jorgeab21/Dise-o_De_Prototipos/hardware/README.md

# KIDBOX — PCB v1.0

> ## Versión de fabricación v1.0 (27-oct-2026)
> Los Gerbers de `fabricacion/KIDBOX_gerbers_v1.0.zip` son la versión para pedir a JLCPCB. Aprobada en la revisión 2 del profesor
> (26-oct), con las pistas a 45° y la prueba 1:1 de la 150 × 70 hecha el 27-oct.
>
> **Cerrado antes de fabricar:**
> - [x] **Prueba 1:1 de la 150 × 70 (27-oct):** escala confirmada con regla. Pantalla, DAC (jack centrado, boca al borde), pulsadores, C3,
>       C4, RP2350-Plus, batería y SW10 calzan. C2 no aparece porque se perdió la pieza (es igual a C3): hay uno de repuesto en
>       `BOM_compra.csv`. Fotos en "Prueba 1:1".
> - [x] **Pistas a 45°:** las 33 esquinas a 90° pasaron a chaflanes; `verificar_extra.py` cuenta 0 esquinas a 90°.
> - [x] **Medidas del DAC (23–26 oct):** placa 31.85 × 17.5 mm (17.3–17.5), columna a 1.5 mm del borde corto y centrada, eje del jack a
>       24.9 mm de la columna, jack de 4.7 × 14 mm que sobresale 1.4 mm. Ya están en la huella propia de J5.
> - [x] **DAC con 3V3 (23-oct):** VIN = 3.26 V, A3V3 = 3.27 V, suena en estéreo con audífonos. Puentes: venían abiertos; en este módulo
>       **H3L controla FMT y H4L controla XSMT**. Quedaron FLT/DEMP/FMT = L y **XSMT = H** (3.21 V). VIN se queda en 3V3.
> - [x] **RP2350-Plus:** 21.0 × 51.55 mm y filas a 17.78 mm (confirmado).
> - [x] **Continuidad de SW10 (21-oct):** la palanca une el común con la pata de su lado. OFF = pad conectado a GND.
> - [x] **Condensadores medidos (21-oct):** C2/C3 con paso de 5 mm; C4 de Ø ≈ 4 mm, alto 7–8 mm y paso 1.5 mm (huella P1.50).
>
> **Pendientes de después de la placa** (no la cambian):
> - [ ] **Al soldar J2, revisar con lupa los cruces entre pines:** **LRCK–RUN** (entre J2.29 y J2.30) y **3V3–RUN** (entre J2.30 y J2.31).
>       Un puente ahí reinicia el módulo. Ver "Notas de montaje".
> - [ ] **SW10:** medir en ON y OFF (3V3_EN ≈ VSYS / 0 V) y la corriente de la batería en OFF (esperable del orden de decenas de µA; si
>       pasa de ≈ 1 mA algo queda alimentado). Sugerencia del profesor 3.5.
> - [ ] **TP1–TP2:** ≈ 3.3 V con SW10 en ON; sin continuidad con la placa armada sin módulos.
> - [ ] **Carcasa:** muro colgante entre pantalla y DAC, y bolsillo de la batería (ver "Carcasa").
> - [ ] **Alto real del jack** sobre la placa del DAC (hoy ≈ 6 mm, provisorio): define la abertura de la carcasa, no la placa.
> - [ ] **Polaridad del adaptador de la batería** (lo hace el profesor): medir con el multímetro antes de conectar (rojo = + → ⊕ del BAT).
> - [ ] Pantalla: revisar el puente J1 del módulo (3.3 V). No afecta a la PCB.

## Qué es

Consola portátil educativa basada en el **Game★Mite v1.3.2 de Thomas Hugo Williams (CC BY 4.0)**. Placa de **150 × 70 mm**, 2 capas,
todo THT, **simétrica respecto de x = 75**. Lleva:
- un **Waveshare RP2350-Plus** (J1/J2, por detrás, centrado, con el USB-C en el borde superior);
- una **pantalla TFT ILI9341 de 2.4"** por SPI (J3, por delante), con la **imagen** centrada en la placa (`tft.setRotation(3)`);
- un **DAC PCM5102A (GY-PCM5102)** por I2S (J5, **por delante**, bajo la pantalla), con el **jack de 3.5 mm centrado** en el borde inferior;
- **8 pulsadores** con capuchones redondos de Ø9: cruceta a la izquierda, A y B en espejo a la derecha, SELECT y START abajo;
- un **interruptor ON/OFF** (SW10, por detrás, arriba a la izquierda) que corta 3V3_EN;
- **TP1 (+3V3) y TP2 (GND)**, puntos de prueba junto a C2;
- una **batería LiPo 103450** que va en un bolsillo de la **carcasa**, detrás, no pegada a la PCB (ver "Carcasa"). Está en el esquemático
  como BT1, excluida de la placa.

Volumen por software, con máximo limitado.

**Referencias que faltan:** no hay C1, J4 ni SW9 porque se eliminaron en la v0.7 (RESET del frente y conector de la pantalla). No se
re-anotó para no cambiar referencias que ya están en la documentación y en las fotos.

## Archivos

La carpeta de entrega (`KIDBOX_PCB_v1.0/`, la arma `scripts/gen_entrega.py`) tiene la misma estructura que el repositorio:

| Ruta | Qué es |
| :--- | :--- |
| `README.md` | Este archivo |
| `ESPECIFICACION.md` | Fuente de verdad del proyecto (la escribe el alumno), v1.0 |
| `DECISIONES.md` | Supuestos y decisiones del diseño, fase por fase (la v0.9 está en las secciones 16 y 17; la v1.0, en la 18) |
| `KIDBOX/` | Proyecto KiCad 10: `KIDBOX.kicad_pro`, `.kicad_sch`, `.kicad_pcb`, `.kicad_dru` (reglas de 0.29 mm), `fp-lib-table` y `KIDBOX.pretty/` (huella propia del DAC) |
| `KIDBOX/BOM.csv` | Lista de materiales del esquemático (referencia, valor, huella, cara, notas) |
| `KIDBOX/BOM_compra.csv` | **Lista de compra completa**: módulos, batería, tiras, pulsadores, capuchones, tornillos, sujeción de la batería y la placa, con cantidades, estado y proveedor (o "por cotizar") |
| `KIDBOX/netlist.csv` | Red, componente, pin y función de cada pin |
| `KIDBOX/verificacion/` | ERC/DRC en JSON, estadísticas, esquemático en SVG, cobre frontal y trasero (SVG), vistas 3D (PNG) y fotos de las pruebas 1:1 |
| `scripts/` | Generadores (huella del DAC, esquemático, BOM/netlist, PCB, fabricación, entrega) y verificaciones; cada uno dice cómo se ejecuta en su cabecera |
| `fabricacion/KIDBOX_gerbers_v1.0.zip` | **Lo que se sube a JLCPCB:** Gerbers + taladros Excellon |
| `fabricacion/gerbers/` | Los mismos archivos sueltos, más los mapas de taladros (PDF) y el reporte de taladros |
| `fabricacion/KIDBOX_1a1_frente_A4.pdf`, `KIDBOX_1a1_reverso_A4.pdf` | Frente y reverso (espejado) a escala real en hoja A4, para la prueba de impresión |
| `fabricacion/KIDBOX_1a1_frente_Carta.pdf`, `KIDBOX_1a1_reverso_Carta.pdf` | Lo mismo en hoja Carta |

Para regenerar todo desde cero (con KiCad cerrado), desde la carpeta raíz:

```
python scripts/gen_huella_dac.py
python scripts/gen_esquematico.py
python scripts/gen_bom_netlist.py
"C:\Program Files\KiCad\10.0\bin\python.exe" scripts/gen_pcb.py
python scripts/verificar.py KIDBOX
"C:\Program Files\KiCad\10.0\bin\python.exe" scripts/verificar_extra.py KIDBOX
python scripts/gen_fabricacion.py
python scripts/gen_entrega.py
```

## Prueba 1:1 (27-oct-2026)

Hecha con `fabricacion/KIDBOX_1a1_frente_A4.pdf` y `KIDBOX_1a1_reverso_A4.pdf` impresos al 100 % (la serigrafía de las fotos todavía dice
v0.9: la geometría es la misma de la v1.0, que solo cambió las esquinas de las pistas y el número de versión).

| Foto | Qué muestra |
| :--- | :--- |
| `KIDBOX/verificacion/prueba_1a1_v09_escala_largo.jpg` | Regla sobre el largo: 150 mm |
| `KIDBOX/verificacion/prueba_1a1_v09_escala_alto.jpg` | Regla sobre el alto: 70 mm |
| `KIDBOX/verificacion/prueba_1a1_v09_frente.jpg` | Frente: pantalla, DAC con el jack centrado y la boca en el borde, pulsadores, C3 y C4 (C2 falta: se perdió la pieza) |
| `KIDBOX/verificacion/prueba_1a1_v09_reverso.jpg` | Reverso: RP2350-Plus, batería en su zona de referencia y SW10 |

Las fotos `prueba_1a1_v07_*.jpg` son de la v0.7 y quedan como historial.

## Carcasa: lo que la placa le exige

- **Muro entre la pantalla y el DAC.** En la placa queda una **franja libre de 4.74 mm** en planta, entre el borde inferior del módulo de
  pantalla (y = 46.36) y el contorno del DAC (y = 51.1), a lo ancho del DAC (x 48.6–80.45). En esa franja no hay piezas de la cara Top;
  solo pistas. El muro va **colgado de la tapa frontal**:
  - mide **≈ 2 mm** de ancho y va centrado en y = 48.73 (línea "muro carcasa" en F.Fab);
  - su altura útil va de **9 a 18 mm sobre la PCB**, porque lo que debe tapar es la placa del DAC (≈ 11–18 mm sobre su socket);
  - termina **≥ 4 mm sobre la PCB**. Las soldaduras de J2.21/J2.22 y J1.19/J1.20 (≈ 2 mm de alto) caen dentro de la franja, así que
    **no hay que apoyar el muro sobre ellas**.
- **Batería en la carcasa, no en la PCB.** La LiPo 103450 va en un **bolsillo de la carcasa con fondo de plástico** entre la batería y la
  placa, con una **sujeción propia** (traba o tapa) y un **canal para el cable** hasta el conector BAT del RP2350-Plus. No se pega a la
  PCB. El rectángulo "BATERÍA 103450" de la serigrafía trasera es solo la referencia de dónde queda, con una flecha hacia el conector BAT.
  Ahí no van componentes altos de la cara Bottom, pero sí hay patas THT (las de START), que quedan bajo el fondo del bolsillo.
  **Orientar la batería con el cable hacia el conector BAT** del módulo (como en la foto del reverso), para que el cable sea corto y no
  cruce sobre el módulo.
- **Capuchones redondos Ø9** impresos en 3D: dejan ≥ 1.5 mm de aire a los módulos (el más justo es RIGHT, a 2.41 mm de la pantalla).
- **Aberturas:** USB-C arriba (x 70.7–79.65) y jack abajo (x 72.65–77.35, boca al ras de y = 70, a ≈ 13–19 mm sobre la placa).

## Orden de soldadura

Las piezas de la **cara Bottom** se insertan por detrás y se sueldan por delante. Las de **Top** se insertan por delante y se sueldan
por detrás. Primero va todo Bottom y después Top, de lo más bajo a lo más alto.

| # | Ref | Cara | Pieza | Cuidado |
| :--- | :--- | :--- | :--- | :--- |
| 1 | J1 | Bottom | Tira hembra 1×20 (pines 1–20 del módulo) | Pin 1 = pad cuadrado, junto al USB-C. Cortar al ras |
| 2 | J2 | Bottom | Tira hembra 1×20 (pines 21–40) | **Poco estaño**: por delante pasan entre sus pines el haz SPI, 3V3 y LRCK (ver notas). Cortar al ras |
| 3 | SW10 | Bottom | Interruptor deslizante, paso 2.54 mm | Palanca hacia atrás; pad central = común. Las patas quedan bajo la pantalla: cortar al ras |
| 4 | C2 | Top | 100 nF cerámico (paso 5 mm) | Vertical junto al pin 1 de J3 |
| 5 | C3 | Top | 100 nF cerámico (paso 5 mm) | Vertical entre SELECT y el DAC, encima de C4 |
| 6 | C4 | Top | 10 µF 25 V electrolítico (Ø4 × 7–8 mm, paso 1.5 mm) | **Respetar la polaridad:** + en el pad cuadrado, del lado de J5 (a la derecha visto de frente). La huella ya tiene paso 1.5 mm: no hay que abrir las patas |
| 7 | J3 | Top | Tira hembra 1×14 (pantalla) | Pin 1 (VCC) arriba, marcado "1". Cortar al ras |
| 8 | J5 | Top | Tira hembra 1×6 (DAC) | VIN = pin 1, pad cuadrado, abajo. El DAC va con sus componentes hacia el frente y el jack hacia el borde inferior |
| 9 | SW1–SW8 | Top | Pulsadores 6×6 | Bien apoyados contra la placa para que los capuchones queden a la misma altura |

TP1 y TP2 son pads de la placa: no llevan pieza.

### Notas de montaje
- **J2 con poco estaño.** Entre sus pines pasan, por la cara donde se suelda, todas a 0.295 mm de cada pad:
  - el haz SPI (5 pistas);
  - **3V3**, entre J2.31 (LCD_LED) y J2.30 (RUN);
  - **I2S_LRCK**, entre J2.30 (RUN) y J2.29 (DIN).

  Hay que **revisar con lupa sobre todo los puentes LRCK–RUN y 3V3–RUN**: el primero reiniciaría el módulo cada vez que suena el
  audio, y el segundo dejaría RUN fijo en 3V3 (y LCD_LED en corto con 3V3 si el puente toca J2.31). Medir que no haya continuidad
  entre J2.30 y J2.29, entre J2.30 y J2.31, ni entre 3V3 (TP1) y J2.30 o J2.31.
- **J3 y J5 sin pistas entre sus pines** (v0.9). Se puede soldar normal.
- **DAC adelante:** la tira macho se suelda con el **plástico del lado sin componentes** del módulo. Los componentes del DAC quedan hacia el
  frente y la boca del jack al ras del borde inferior. Bajo el DAC no queda ninguna pata salvo las de J5, así que el módulo también se
  puede soldar directo a la placa para bajar el grosor.
- **Puentes del DAC:** FLT, DEMP y FMT = L; **XSMT = H** (sin él, el DAC queda en silencio). En este módulo H3L controla FMT y H4L controla XSMT.
- **Cortar al ras las patas de J1, J2, J3 y SW10** después de soldar: las de J1/J2 y SW10 quedan bajo la pantalla.
- La placa no tiene vías. La cara de atrás es un plano de masa con alivios térmicos, así que los pads de GND se sueldan igual que los demás.
- Antes de poner los módulos: medir que no haya corto entre **TP1 (3V3) y TP2 (GND)**.
- Firmware: `tft.setRotation(3)`; volumen limitado por software.

## Pedido en JLCPCB

| Parámetro | Valor |
| :--- | :--- |
| Archivo | `fabricacion/KIDBOX_gerbers_v1.0.zip` (extensiones Protel, Gerber X2, taladros Excellon en mm con origen absoluto) |
| Base material | FR-4 |
| Layers | **2** |
| Dimensions | **150 × 70 mm** (lo detecta solo; el sobrecosto por pasar de 100 × 100 mm está aceptado) |
| PCB Qty | 5 (mínimo) |
| Product type | Industrial/Consumer electronics |
| Different design | 1 |
| Delivery format | Single PCB |
| PCB thickness | **1.6 mm** |
| PCB color | **Verde** |
| Silkscreen | Blanco |
| Surface finish | **HASL (with lead free)** |
| Outer copper weight | 1 oz |
| Via covering | Tented (la placa no tiene vías) |
| Mark on PCB / order number | **Order number: Specify a location**: va donde está el texto "JLCJLCJLCJLC" de la serigrafía inferior, dentro de la zona de batería |
| Gold fingers, castellated holes, edge plating | No |
| **PCB Assembly (PCBA)** | **No** (sin ensamblaje) |
| Stencil | No |
| Resto de opciones | Las que JLCPCB trae por defecto |

## Qué revisar en el visor de Gerbers de JLCPCB antes de pagar

1. **2 capas y 150 × 70 mm.** El contorno tiene esquinas redondeadas (r = 4 mm), sin líneas sueltas ni recortes de más.
2. **Taladros: 107 en total.**
   - 103 metalizados: 2 × 0.6 mm (C4), 7 × 0.8 mm (C2, C3 y SW10), 62 × 1.0 mm (J1, J2, J3, J5, TP1 y TP2) y 32 × 1.1 mm (pulsadores).
   - 4 sin metalizar de 2.2 mm, en las esquinas (4, 4), (146, 4), (4, 66) y (146, 66).
   - Dentro del rectángulo "BATERÍA 103450" (por detrás) solo caen las patas de START: la batería va en la carcasa, no sobre la placa.
3. **Cobre superior (Top):** todas las pistas están aquí, con todas las esquinas a 45° (ninguna a 90°). Las de señal son de 0.25 mm y las de 3V3 de 0.5 mm, salvo un tramo de 0.25 mm entre
   dos pines de J2. Ninguna pista toca un pad que no le corresponde. No hay vías.
4. **Cobre inferior (Bottom):** un plano de masa casi completo. Los pads de GND tienen alivios térmicos (4 "radios") y los demás pads,
   un anillo libre a su alrededor. No hay pistas.
5. **Máscara:** hay abertura en todos los pads, y ninguna sobre las pistas ni sobre el plano.
6. **Serigrafía superior:**
   - UP, DOWN, LEFT, RIGHT, A, B, SELECT y START junto a sus botones (texto de 1.2 mm);
   - el contorno de la pantalla con "PANTALLA TFT 2.4" (J3)" y "1" junto al pin 1 de J3, y dentro el contorno de la imagen;
   - el contorno del DAC con el jack, "DAC PCM5102", "VIN" y "GND" junto a J5;
   - "3V3" y "GND" junto a TP1 y TP2;
   - los créditos del Game*Mite entre el DAC y START.
7. **Serigrafía inferior.** En la vista desde arriba se ve espejada, que es lo correcto; al dar vuelta la placa en el visor se lee al derecho:
   - "VISTA POSTERIOR / FILAS ESPEJADAS", el contorno de la RP2350-Plus con el USB-C arriba y "1" en J1 y J2;
   - "OFF" y "ON" en SW10 (desde atrás, arriba a la derecha, con OFF a la izquierda);
   - "BATERÍA 103450 / va en la carcasa, no pegar a la PCB" con una flecha hacia el conector BAT, y el cajetín
     "KIDBOX v1.0 – 150 x 70 mm – 1.6 mm – 2 capas" abajo (a la izquierda al dar vuelta la placa).
8. Ningún texto de serigrafía cae sobre un pad. El DRC dio 0 avisos, pero hay que confirmarlo a la vista.
9. En la serigrafía inferior aparece **"JLCJLCJLCJLC"** en vertical, dentro de la zona de batería, junto a "BATERÍA 103450". Ahí JLCPCB pone su número de pedido (con "Specify a location").
10. Precio y plazo coherentes con 5 placas de 150 × 70 mm, sin ensamblaje ni opciones extra marcadas por error.

## Verificación del diseño (27-oct-2026)

`verificar.py`: ERC 0/0 · DRC 0 errores, 0 avisos (con las reglas de 0.29 mm de `KIDBOX.kicad_dru`) · 0 sin conectar · paridad
esquemático-PCB 0 · mínimos DFM OK.

`verificar_extra.py`:
- ERC y DRC con los tests que el proyecto ignora activados: 0.
- Emulación de "Actualizar PCB desde esquemático" (F8): 0 cambios.
- Esquinas de pista: 115 vértices, 112 a 45° y 3 colineales; **0 a 90°**.

Detalle y holguras medidas en `DECISIONES.md`, secciones 16 a 18.

Licencia y créditos: basado en el Game★Mite de Thomas Hugo Williams (CC BY 4.0).
