jorgeab21/Dise-o_De_Prototipos/hardware/fabricacion/gerbers/KIDBOX-drill_report.txt

Drill report for KIDBOX.kicad_pcb
Created on 2026-10-27T09:46:37

Copper Layer Stackup:
    =============================================================
    L1 :  F.Cu                      front
    L2 :  B.Cu                      back

Drill file 'KIDBOX-PTH.drl' contains
    plated through holes:
    =============================================================
    T1  0.600mm  0.0236"  (2 holes))
    T2  0.800mm  0.0315"  (7 holes))
    T3  1.000mm  0.0394"  (62 holes))
    T4  1.100mm  0.0433"  (32 holes))

    Total plated holes count 103

Drill file 'KIDBOX-NPTH.drl' contains
    unplated through holes:
    =============================================================
    T1  2.200mm  0.0866"  (4 holes))

    Total unplated holes count 4
