jorgeab21/Dise-o_De_Prototipos/4.KIDBOX_Diagrama_arquitectura_del_Sistema.md

# KIDBOX — Diagrama y Arquitectura del Sistema
**Documento de Arquitectura de Hardware, Software e Integración Tecnológica · Versión 1.0 (KIDBOX V1)**  
*Proyecto: Consola Portátil Educativa para Niños de 6 a 10 Años*

---

## 1. Arquitectura de Hardware

La arquitectura de hardware de **KIDBOX V1** se articula en torno al microcontrolador **RP2350A** montado en la placa de desarrollo **Waveshare RP2350-Plus**. Este microcontrolador gobierna directamente los periféricos de salida visual (SPI), audio digital (I2S) y entrada de usuario (GPIO dedicados).

### 1.1. Diagrama de Conexiones y Buses

```text
                                 KIDBOX V1
                                     │
                           Waveshare RP2350-Plus
                                 (RP2350A)
                                     │
          ┌──────────────────────────┼──────────────────────────┐
          │                          │                          │
       Bus SPI                    Bus I2S                   GPIO Directo
          │                          │                          │
          ▼                          ▼                          ▼
    ILI9341 2.4"                 PCM5102A                   8 botones
      320 × 240                      │                    ↑ ↓ ← →, A, B
          │                          ▼                    Start, Select
          │                          │                   (+ RESET → RUN)
          │                     Jack 3.5 mm
          │                          │
          │                          ▼
          │                      Audífonos
          │
    ┌─────┴──────┐
    │  XPT2046   │  ───► [NO USADO en V1: sin cablear en la PCB]
    │ Touch SPI  │
    ├────────────┤
    │  MicroSD   │  ───► [NO USADO en V1: sin cablear en la PCB]
    │ Socket SPI │
    └────────────┘
```

El detalle de cada conexión (esquemático aprobado, ERC sin errores) está en [hardware/KIDBOX/KIDBOX.kicad_sch](hardware/KIDBOX/KIDBOX.kicad_sch) y [hardware/KIDBOX/netlist.csv](hardware/KIDBOX/netlist.csv).

---

### 1.2. Sistema de Energía y Alimentación

La placa Waveshare RP2350-Plus integra la etapa de gestión de potencia, evitando la necesidad de módulos de carga externos adicionales como el TP4056:

```text
                           SISTEMA DE ENERGÍA

                         Batería LiPo 3.7 V (1S)
                              1000–1200 mAh
                                    │
                                    ▼ [Conector 2P, paso 1,25 mm]
                          Waveshare RP2350-Plus
                     ┌──────────────┴──────────────┐
                     │                             │
             Cargador Integrado            Regulación Integrada
                 (ETA6096)                       (MP28164)
                     │                             │
              Puerto USB-C                  Alimentación 3.3 V
         (Carga y Programación)                    │
                                            Pin 3V3_EN (red PWR_EN)
                                                   │
                                             Interruptor ON/OFF
                                     (deslizante recto, cara posterior, a GND)
```

> [!TIP]
> **Gestión de Encendido Limpia:**  
> El interruptor de encendido general conmuta el pin `3V3_EN` a `GND`. Esto apaga el convertidor DC-DC interno MP28164 (buck-boost que genera los 3,3 V de la electrónica) sin cortar la línea directa entre la batería y el cargador ETA6096, permitiendo recargar la consola mediante USB-C incluso estando apagada.

> [!WARNING]
> **Corriente de carga:** el ETA6096 viene configurado a ~1 A. Con la batería actual de 500 mAh eso es ~2C, el doble de lo recomendable. Se decide con el profesor el 14-oct (batería de 1000–1200 mAh o cambio de R13). Mientras tanto, las pruebas se hacen solo por USB-C, sin batería conectada.

---

## 2. Presupuesto General de Pines GPIO

Gracias a la alta disponibilidad de pines del microcontrolador RP2350A en la placa Waveshare, **no se requiere el uso de expansores I²C (e.g. PCF8574), matrices de teclado ni registros de desplazamiento (e.g. 74HC165)**. Todos los componentes se conectan a líneas dedicadas:

| Bloque Funcional | Líneas / Pines Asignados | Detalle de Señales |
|:---|:---:|:---|
| **Botones Físicos (8 de juego)** | **8** | `DOWN` GP16, `LEFT` GP17, `UP` GP18, `RIGHT` GP19, `SELECT` GP12, `START` GP13, `B` GP14, `A` GP15. Cada botón conecta su GPIO a GND; pull-up interno activado por software (pulsado = LOW). |
| **Pantalla TFT ILI9341 (SPI0)** | **6** | `CS` GP0, `RST` GP1, `DC` GP2, `MOSI` GP3, `SCK` GP6 y `LED` GP26 (brillo por PWM). MISO no se usa. |
| **DAC de Audio PCM5102A (I2S)** | **3** | `BCK` GP20, `LRCK` GP21 (deben ser consecutivos para la librería I2S) y `DIN` GP22. El pin `SCK` del DAC va a GND (reloj interno). |
| **Control del módulo** | **2 (no son GPIO)** | `RESET` al pin `RUN`; interruptor ON/OFF al pin `3V3_EN`. |
| **Telemetría de Batería** | **Por verificar** | En la Raspberry Pi Pico, VSYS/3 se lee en un canal ADC interno; falta confirmar en el esquemático de la RP2350-Plus si existe el mismo divisor. |
| **TOTAL EN USO** | **17 GPIO** | Quedan libres GP4, GP5, GP7–GP11, GP27 y GP28. |

> [!NOTE]
> Los pines correspondientes al digitalizador táctil (XPT2046) y al lector de tarjeta MicroSD de la pantalla **no se cablean en la PCB** de KIDBOX V1, simplificando el ruteo y reduciendo el consumo energético.

---

## 3. Arquitectura del Software

El flujo lógico del sistema está diseñado para ofrecer una experiencia cerrada, amigable y centrada en el bienestar infantil, garantizando sesiones de juego con límites temporales automáticos.

### 3.1. Flujo de Ejecución y Ciclo de Vida

```text
                     ENCENDIDO
                         │
                         ▼
             Inicialización Hardware
        (Reloj, Display SPI, DAC I2S, GPIOs)
                         │
                         ▼
                    Logo KIDBOX
                (Jingle de bienvenida)
                         │
                         ▼
                  MENÚ PRINCIPAL
                         │
          ┌──────────────┴──────────────┐
          │                             │
     Categoría:                    Categoría:
      [ JUGAR ]                   [ APRENDER ]
          │                             │
          └──────────────┬──────────────┘
                         │
                         ▼
                  Selección Juego
                         │
                         ▼
               Inicio Temporizador
             (Sesión limitada activa)
                         │
                         ▼
                     GAMEPLAY
                         │
                         ▼
             Aviso de Tiempo Restante
             (Alerta visual / acústica)
                         │
                         ▼
                  FIN DE SESIÓN
         (Pausa amigable de tiempo cumplido)
                         │
                         ▼
                  Menú Principal
```

### 3.2. Catálogo Inicial de Software

Los títulos de lanzamiento para KIDBOX V1 se agrupan en dos categorías balanceadas:

```
                    BIBLIOTECA DE TÍTULOS (V1)
 ┌──────────────────────────────────────────────────────────────────┐
 │                     JUEGOS EDUCATIVOS                            │
 │  • Memoria: Secuencias de colores y sonidos (tipo Simon Says)     │
 │  • Matemáticas: Desafíos rápidos de cálculo mental y sumas        │
 │  • Lógica y Patrones: Completar secuencias lógicas y matrices     │
 │  • Reacción: Estimulación visomotora con pulsación oportuna       │
 ├──────────────────────────────────────────────────────────────────┤
 │                  JUEGOS DE ENTRETENIMIENTO                       │
 │  • Snake: Navegación clásica y control de velocidad en cuadrícula │
 │  • Pong: Juego de raquetas con rebote angular                     │
 │  • Breakout / Ladrillos: Destrucción de bloques con física básica│
 └──────────────────────────────────────────────────────────────────┘
```

> [!IMPORTANT]
> **Pendiente de decisión del equipo:** la propuesta original ([Documentacion/KIDBOX.md](Documentacion/KIDBOX.md)) define una biblioteca de **3 a 4 juegos**, cada uno con un objetivo cognitivo, con un diseño que acompaña la frustración (**sin cronómetro ni pantalla de game over**) y sin mecánicas de presión. Varios títulos de este catálogo (Snake, Pong, Breakout, desafíos "rápidos" y de reacción) incluyen game over o presión de tiempo. Hay que definir si se mantienen (por ejemplo, adaptados con dificultad adaptativa y sin game over), se reemplazan o se reduce el catálogo.

### 3.3. Plataforma de Desarrollo

- **Entorno:** Arduino IDE (recomendación del profesor), con el núcleo *arduino-pico*, que soporta RP2040 y RP2350.
- **Librerías:** pantalla ILI9341 por SPI y salida de audio I2S. Las librerías específicas quedan por definir en las pruebas de protoboard.
- **Carga del firmware:** por USB-C, arrastrando el archivo UF2 o directamente desde el IDE.
- **Rotación de pantalla:** el módulo va montado girado 180° en la PCB; la imagen se endereza por software (`setRotation`).

---

## 4. Estrategia Tecnológica: Open Source vs. Desarrollo Propio

El proyecto adopta un enfoque híbrido pragmático: aprovecha referencias técnicas y librerías probadas de código abierto para acelerar la validación funcional, pero desarrolla de forma propietaria la electrónica, el diseño industrial y la experiencia de usuario:

| Componente / Módulo | Tipo de Origen | Descripción y Rol en el Proyecto |
|:---|:---:|:---|
| **Game★Mite** (CC BY 4.0) | `Referencia Open Source` | Base del hardware: asignación de pines de pantalla y botones, módulos sobre tiras hembra y criterio de batería. Se le da crédito en la serigrafía de la PCB. |
| **PicoMite (MMBasic)** | `Referencia` | Firmware que usa el Game★Mite. KIDBOX **no** lo usa: el firmware se programa en Arduino. |
| **ESP32-Emu-Turbo** | `Referencia Mecánica` | Estudio previo de integración volumétrica de componentes y ergonomía de carcasas impresas. |
| **Carrier PCB KIDBOX** | `Desarrollo Propio` | Placa portadora de 2 capas diseñada desde cero para interconectar módulos, pulsadores y regulación. |
| **Carcasa KIDBOX** | `Desarrollo Propio / Adaptado` | Diseño CAD 3D exclusivo con bisel protector de pantalla, bahía aislada para LiPo y ensamblado con insertos M2. |
| **Distribución Ergonómica** | `Desarrollo Propio` | Geometría horizontal calibrada con separación de controles adecuada para manos infantiles (6 a 10 años). |
| **Interfaz Gráfica KIDBOX** | `Desarrollo Propio` | Sistema de menús minimalistas, iconografía de alta legibilidad y navegación amigable sin distracciones. |
| **Temporizador de Sesión** | `Desarrollo Propio` | Rutina en background que gestiona el control de tiempo saludable y lanza avisos sonoros/visuales de término de sesión. |
| **Juegos Educativos** | `Desarrollo Propio / Adaptado` | Mecánicas diseñadas específicamente para ejercitar atención, cálculo mental, memoria y tolerancia a la frustración. |

---

## 5. Documentos Relacionados

- **Requisitos del Producto:** [1.KIDBOX_Requisitos_y_Requerimientos_Tecnicos.md](1.KIDBOX_Requisitos_y_Requerimientos_Tecnicos.md)
- **Diseño Mecánico y Bocetos:** [2.KIDBOX_Diagramas_Bocetos_Diseno_Fisico.md](2.KIDBOX_Diagramas_Bocetos_Diseno_Fisico.md)
- **Lista de Materiales (BOM):** [3.KIDBOX_Lista_componentes_electrónicos.md](3.KIDBOX_Lista_componentes_electrónicos.md)
- **Especificación y esquemático de la PCB:** [hardware/ESPECIFICACION.md](hardware/ESPECIFICACION.md) · [hardware/KIDBOX/](hardware/KIDBOX/)
