jorgeab21/Dise-o_De_Prototipos/1.KIDBOX_Requisitos_y_Requerimientos_Tecnicos.md

# KIDBOX — Lista de Requisitos y Requerimientos Técnicos
**Documento de Especificación de Producto · Versión 1.0 (KIDBOX V1)**  
*Proyecto: Consola Portátil Educativa para Niños de 6 a 10 Años*

---

## 1. Objetivo del Producto

> **KIDBOX** es una consola portátil orientada a niños de 6 a 10 años, diseñada para ofrecer juegos educativos y de entretenimiento en un entorno controlado, sin navegador, publicidad, compras integradas, redes sociales ni otras distracciones propias de un teléfono inteligente o tablet.

El propósito central es proporcionar a los cuidadores una alternativa confiable y saludable frente a las pantallas convencionales, permitiendo a los niños entrenar habilidades cognitivas (atención, memoria, razonamiento lógico y tolerancia a la frustración) mediante dinámicas de juego atractivas y sesiones de tiempo autolimitadas por el propio hardware.

---

## 2. Requisitos Funcionales

La priorización sigue el estándar **MoSCoW** adaptado al prototipo de ingeniería (*Debe tener* / *Deseable*):

| ID | Requisito Funcional | Prioridad | Descripción / Criterio de Aceptación |
|:---:|:---|:---:|:---|
| **RF01** | **Operación 100% Offline** | `Debe tener` | El dispositivo funciona de manera autónoma sin requerir conectividad Wi-Fi, Bluetooth o acceso a Internet durante su operación normal. |
| **RF02** | **Ejecución de Juegos Educativos y Lúdicos** | `Debe tener` | Capacidad de inicializar y alternar entre títulos de juego prediseñados para la plataforma. |
| **RF03** | **Enfoque en Desarrollo Cognitivo** | `Debe tener` | La biblioteca incluye dinámicas orientadas a la ejercitación de memoria, lógica deductiva, cálculo mental, reconocimiento de patrones y tiempo de reacción. |
| **RF04** | **Navegación por Controles Físicos** | `Debe tener` | Interacción completa de menús y gameplay efectuada exclusivamente mediante la cruceta direccional y pulsadores físicos dedicados. |
| **RF05** | **Temporizador de Sesión Incorporado** | `Debe tener` | Control interno de tiempo de uso continuo que establece límites saludables de juego predefinidos. |
| **RF06** | **Notificación de Término de Sesión** | `Debe tener` | La consola alerta de forma visual y sonora al usuario cuando el tiempo límite de juego concluye, bloqueando o pausando amigablemente la partida. |
| **RF07** | **Entorno Seguro sin Distracciones** | `Debe tener` | Ausencia total de navegadores web, pasarelas de pago, micropagos, anuncios publicitarios o acceso a plataformas de interacción social. |
| **RF08** | **Interfaz Gráfica Intuitiva** | `Debe tener` | Menú principal y señalética visual sencilla, comprensible, accesible e iconográfica para el público infantil de 6 a 10 años. |
| **RF09** | **Ejecución Autónoma desde Memoria Interna** | `Debe tener` | Los juegos y assets se leen y ejecutan directamente desde la memoria Flash del microcontrolador, sin dependencia obligatoria de medios extraíbles. |
| **RF10** | **Escalabilidad para Touch y MicroSD** | `Deseable` | El hardware deja disponibles los pines y pistas para habilitar en revisiones futuras (V2+) el panel táctil resistivo y/o el lector de tarjetas MicroSD. |

---

## 3. Requerimientos Técnicos

Especificación técnica de la plataforma de hardware para la versión de validación **KIDBOX V1**:

| Subsistema / Parámetro | Requerimiento KIDBOX V1 | Especificación Técnica & Justificación |
|:---|:---|:---|
| **Microcontrolador (MCU)** | Waveshare RP2350-Plus | Arquitectura dual-core ARM Cortex-M33 / Hazard3 RISC-V @150 MHz, alto rendimiento gráfico y periféricos PIO. |
| **Pantalla Display** | TFT IPS 2.4" ILI9341 | Panel color de 262K colores, ángulo de visión amplio, controlador ILI9341 integrado. |
| **Resolución** | 240 × 320 px (orientación 320 × 240) | Uso prioritario en orientación apaisada (*landscape*) para adaptarse al formato ergonómico de consola portátil. |
| **Bus de Comunicación Display** | SPI dedicado | Interfaz de 4 hilos a alta frecuencia para refresco de cuadros óptimo. |
| **Interfaz de Control** | 8 botones físicos tipo Tact Switch | D-Pad (↑, ↓, ←, →), botones de acción (A, B) y utilitarios (Start, Select) mediante switches de 6×6 mm con lectura por GPIO directo con pull-up. |
| **Procesamiento de Audio** | DAC I2S PCM5102A (GY-PCM5102) | Decodificación de audio digital por I2S de alta fidelidad, con bajo consumo y bajo nivel de ruido. |
| **Salida de Audio** | Jack de audio estéreo 3.5 mm | Conector hembra integrado en el módulo DAC para audífonos estándar (limita el ruido ambiental para terceros). |
| **Almacenamiento Primario** | Memoria Flash integrada en placa MCU | Flash QSPI (≥4 MB / 16 MB) para almacenamiento directo de binarios de firmware, sprites y pistas de audio sintetizadas. |
| **Zócalo MicroSD** | Físicamente presente, no habilitado en V1 | Conector de la pantalla reservado sin cablear en firmware inicial para simplificar validación en protoboard/carrier. |
| **Digitalizador Táctil (Touch)** | Controlador XPT2046 presente, no utilizado | Deshabilitado en V1 para centrar toda la experiencia en controles mecánicos robustos. |
| **Batería** | LiPo 1S 3.7 V (1000–1200 mAh) | Celda recargable de polímero de litio con circuito de protección PCM incorporado (tolerancia dimensional estricta ≤10 mm de espesor). |
| **Circuito de Carga** | ETA6096 integrado en RP2350-Plus | Carga lineal administrada directamente en el módulo MCU mediante conector JST 1.25 mm a ~1 A. |
| **Corriente Admisible de Celda** | $\ge 1\text{ A}$ continuo | Certificada por ficha técnica para garantizar una recarga segura al régimen nominal del cargador integrado. |
| **Autonomía Estimada** | 4 a 6 horas continuas | Estimación sujeta a perfil de brillo de backlight y volumen sonoro medio; pendiente de validación empírica. |
| **Control de Encendido** | Switch mecánico a pin `PWR_EN` | Conmutador ON/OFF conectado entre `PWR_EN` y `GND` que desactiva el regulador MP28164 sin cortar la línea de recarga USB-C. |
| **Placa de Enlace (Carrier PCB)** | PCB personalizada de 2 capas | Placa portadora para ruteo de señales, distribución de masas continuas y desacoplo capacitivo. |
| **Puerto de Alimentación / Debug**| USB Tipo-C | Conector reversible en módulo Waveshare para programación mediante UF2 y suministro de carga. |
| **Montaje y Conectividad** | Headers 2.54 mm & componentes THT | Ensamblado modular desmontable mediante tiras de pines para facilitar diagnóstico, reemplazo y medición en laboratorio. |

> [!NOTE]
> Para conocer el desglose detallado de piezas, estados de disponibilidad en el DEC UAI y proveedores, consultar el archivo [3.KIDBOX_Lista_componentes_electrónicos.md](file:///c:/Users/Usuario/Dise-o_De_Prototipos/3.KIDBOX_Lista_componentes_electrónicos.md).

---

## 4. Requisitos Físicos, Ergonómicos y de Uso

### 4.1. Filosofía de Diseño Infantil
La consola está concebida bajo criterios estrictos de seguridad y adaptabilidad biomecánica para usuarios de 6 a 10 años:
- **Agarre ergonómico:** Bordes perimetrales suavizados y esquinas redondeadas con radio amplio, evitando cantos vivos o aristas punzantes.
- **Distribución de mandos:** Botones de dimensiones adecuadas, con espaciado generoso para evitar pulsaciones involuntarias en manos en etapa de desarrollo motor.
- **Protección de pantalla:** El panel TFT debe estar ubicado en un plano rebajado (*recessed*) dentro del bisel de la carcasa, protegiéndolo de impactos directos al apoyar o caer boca abajo.
- **Seguridad pasiva:** Compartimento de batería inaccesible para el niño, sin piezas desmontables pequeñas que presenten riesgo de atragantamiento o ingestión.

### 4.2. Metas Paramétricas y Mecánicas

| Parámetro Físico | Valor Objetivo V1 | Criterio de Diseño & Verificación |
|:---|:---:|:---|
| **Ancho total** | ~150 – 170 mm | Permite una separación cómoda de ambas manos en agarre horizontal. |
| **Alto total** | ~70 – 90 mm | Altura reducida para que los pulgares alcancen naturalmente el D-Pad y botones. |
| **Grosor máximo** | $\le 35\text{ mm}$ | Balance entre robustez estructural y volumen manejable para niños. |
| **Peso total** | $\le 250\text{ g}$ | Evita fatiga muscular durante sesiones de 20–40 minutos. |
| **Disposición de Pantalla** | Frontal centrada | Minimiza inclinación del cuello y maximiza balance simétrico del peso. |
| **Alojamiento de Batería** | Bahía aislada sin compresión | Espacio de $\sim 21.5 \times 54\text{ mm}$ con tolerancia libre para prevenir estrés mecánico en la celda LiPo. |
| **Método de Ensamble** | Tornillos M2/M2.5 con insertos roscados | Uniones roscadas fiables y duraderas que permiten desarmar y calibrar sin desgastar el plástico impreso. |
| **Resistencia Mecánica** | Grado doméstico infantil | Estructura exterior capaz de soportar torsiones leves, caídas accidentales de baja altura (~1 m sobre madera) y uso rudo diario. |

---

## 5. Resumen de Estados de Implementación

```
                    ARQUITECTURA DE REQUISITOS (V1)
 ┌───────────────────────────────────────────────────────────────────┐
 │                       REQUISITOS BASE (100% CUMPLIDOS)            │
 │  • Funcionamiento Offline autónomo                                │
 │  • Interfaz gráfica infantil y amigable                           │
 │  • Juegos cognitivos y lúdicos en memoria interna                 │
 │  • Control físico integral (8 botones)                            │
 │  • Gestión de sesión (tiempo y alerta)                            │
 ├───────────────────────────────────────────────────────────────────┤
 │                    PLATAFORMA HARDWARE ACTIVA                     │
 │  • MCU Waveshare RP2350-Plus + TFT 2.4" SPI                       │
 │  • DAC I2S PCM5102A + Jack 3.5mm                                  │
 │  • LiPo 1S + Cargador ETA6096 + Switch a PWR_EN                   │
 ├───────────────────────────────────────────────────────────────────┤
 │                   RESERVADO PARA FASES POSTERIORES                │
 │  • Digitalizador Touch XPT2046                                    │
 │  • Slot lector MicroSD externo                                    │
 └───────────────────────────────────────────────────────────────────┘
```
