jorgeab21/Dise-o_De_Prototipos/6.KIDBOX_Plan_de_Desarrollo.md

# KIDBOX — Plan de Desarrollo y Gestión de Riesgos
**Cronograma Maestro, Plan de Contingencias y Priorización de Desarrollo · Entrega Final: 13 de Noviembre de 2026**  
*Proyecto: Consola Portátil Educativa para Niños de 6 a 10 Años (KIDBOX V1)*

---

## 1. Estrategia General de Desarrollo

Tomando como fecha límite improrrogable el **13 de noviembre de 2026**, la estrategia de ingeniería se fundamenta en:

1. **Cierre temprano de arquitectura de hardware:** Congelar componentes críticos de inmediato para disparar los pedidos de compra y el diseño de la PCB sin retrasos de logística.
2. **Desarrollo concurrente en banco de pruebas:** Trabajar el firmware sobre protoboard en paralelo a los tiempos de fabricación y envío de la placa de circuito impreso.
3. **Margen holgado de integración:** Reservar los últimos 10 días exclusivamente para ensamble físico, calibración de autonomía de batería, pruebas de estrés con usuarios y documentación final.

---

## 2. Cronograma Maestro de Hitos

El plan se divide en cinco etapas coordinadas:

| Fecha Estimada | Fase / Hito Principal | Resultado Entregable Esperado | Estado / Responsabilidad |
|:---:|:---|:---|:---:|
| **13 – 15 oct** | **Congelar arquitectura y BOM** | Lista de materiales cerrada: Waveshare RP2350-Plus, TFT ILI9341 2.4", DAC PCM5102A y batería LiPo 1S definidos. | `Hito Crítico` |
| **14 – 18 oct** | **Prototipo electrónico inicial** | Validación en protoboard: pantalla SPI, pulsadores GPIO y audio I2S verificados individualmente. | `En Proceso` |
| **15 – 19 oct** | **Esquemático KiCad** | Circuito completo interconectado, asignación de pines GPIO definitiva y verificación ERC sin errores. | `Planificado` |
| **19 – 23 oct** | **Layout PCB (2 capas)** | Ruteo de señales de alta velocidad (SPI), planos de masa analógica/digital y distribución física de pulsadores. | `Planificado` |
| **23 – 24 oct** | **Revisión DRC y fabricación** | Verificación de reglas de diseño (DRC) del fabricante y generación de archivos Gerber / Drill. | `Planificado` |
| **24 – 25 oct** | **Envío a fabricación PCB** | Orden de fabricación emitida a fábrica (e.g. JLCPCB / PCBWay) para asegurar entrega en plazo. | `Hito Crítico` |
| **18 – 30 oct** | **Firmware base y subsistemas** | Drivers de pantalla, lectura de pulsadores con debouncing por interrupción y máquina de estados del menú principal. | `Concurrente` |
| **22 oct – 3 nov** | **Desarrollo de biblioteca de juegos** | Implementación del primer conjunto jugable (juegos educativos de cálculo/memoria y clásicos lúdicos). | `Concurrente` |
| **22 oct – 3 nov** | **Diseño CAD de carcasa 3D** | Modelado 3D en CAD con bisel rebajado para TFT, alojamiento de celda LiPo e insertos roscados M2/M2.5. | `Concurrente` |
| **3 – 7 nov** | **Recepción y montaje de PCB** | Soldadura de conectores hembra, headers 2.54 mm, tact switches y pasivos en la carrier PCB. | `Planificado` |
| **6 – 9 nov** | **Integración mecatrónica completa** | Ensamble de PCB + pantalla + DAC + batería dentro de la carcasa impresa 3D mediante tornillería métrica. | `Hito Crítico` |
| **9 – 11 nov** | **Pruebas de validación y estrés** | Medición de autonomía real (h), respuesta táctil de botones, calidad de audio y ciclo del temporizador. | `Planificado` |
| **11 – 12 nov** | **Ajustes finales y memoria técnica** | Correcciones menores de software, pulido estético de carcasa y redacción del informe técnico final. | `Planificado` |
| **13 nov** | **ENTREGA FINAL DEL PRODUCTO** | **Presentación y entrega formal de la consola KIDBOX V1 operativa.** | `ENTREGA` |

---

## 3. Prioridad de Desarrollo Incremental (Estrategia MVP)

Para evitar llegar a la fecha límite con múltiples módulos a medio terminar, se adopta un **enfoque incremental estricto**. No se avanza al siguiente paso sin tener el anterior 100% operativo y probado:

```text
 ┌─────────┐      ┌─────────┐      ┌─────────┐      ┌──────────┐      ┌─────────┐
 │ 1. TFT  │ ───► │ 2. Gpio │ ───► │ 3. Menú │ ───► │ 4. Juego │ ───► │ 5. Audio│
 │ Display │      │ Botones │      │ Sistema │      │ Piloto 1 │      │   I2S   │
 └─────────┘      └─────────┘      └─────────┘      └──────────┘      └─────────┘
                                                                           │
 ┌───────────────┐      ┌───────────────┐      ┌───────────────┐           │
 │ 9. Integración│ ◄─── │  8. Carcasa   │ ◄─── │ 7. Catálogo   │ ◄─────────┘
 │     Final     │      │   Impresa 3D  │      │ Resto Juegos  │  [+ 6. Batería LiPo]
 └───────────────┘      └───────────────┘      └───────────────┘
```

### Justificación de la Secuencia:
1. **Pantalla:** La retroalimentación visual es indispensable para diagnosticar y depurar todo el resto del sistema.
2. **Botones:** Permite interactuar con la consola de forma física sin depender del puerto serie del PC.
3. **Menú Base:** Establece la máquina de estados sobre la cual correrán todos los títulos.
4. **Primer Juego Piloto:** Demuestra la viabilidad del ciclo de refresco (*game loop*) y tiempo de respuesta.
5. **Audio I2S:** Aporta enriquecimiento sonoro sin condicionar el avance de la lógica de juego.
6. **Batería:** Asegura la portabilidad una vez estabilizado el consumo promedio.
7. **Resto de Juegos:** Expansión modular del catálogo educativo/lúdico.
8. **Carcasa e Integración:** Solo se imprime y ajusta con las medidas reales y validadas de los módulos ensamblados.

---

## 4. Matriz de Riesgos y Planes de Contingencia (Plan B)

Cada contingencia técnica y logística cuenta con un procedimiento de mitigación predefinido para proteger la entrega final:

| Riesgo Técnico / Logístico | Nivel de Impacto | Plan de Contingencia Inmediato (Plan B) |
|:---|:---:|:---|
| **Retraso en la llegada de la PCB** | `Alto` | Montaje del circuito equivalente sobre **protoboard rígida o perfboard cableada a mano** para la demostración funcional. |
| **Error de ruteo o footprint en la PCB** | `Medio` | Corrección manual mediante **jumper wires (puentes)** y corte de pistas con bisturí, documentando el parche técnico para la revisión V1.1. |
| **La pantalla TFT ILI9341 2.4" no llega a tiempo** | `Alto` | Uso temporal de la pantalla **ST7789 1.3" (240×240 px)** disponible en el DEC UAI, adaptando el driver en software. |
| **Batería LiPo no llega o excede las dimensiones** | `Medio` | Demostración funcional alimentando la consola directamente mediante el **puerto USB-C** o con portapilas externo temporal. |
| **El módulo DAC I2S PCM5102A presenta fallas** | `Bajo` | Validar y presentar la consola **sin audio inicialmente**, dejando el sistema sonoro como actualización de firmware secundaria. |
| **Retraso en la finalización de todos los juegos** | `Medio` | Reducir el alcance del catálogo: entregar el **menú principal más 2 a 3 juegos completamente pulidos y libres de bugs**. |
| **Desajuste dimensional en la carcasa impresa** | `Bajo` | Diseño modular por secciones que permite la **reimpresión rápida (1–2 h)** únicamente de la tapa frontal o soportes internos. |

---

## 5. Documentos Relacionados del Proyecto

Para consultar los antecedentes técnicos, listas de materiales y bocetos del proyecto:

1. [1.KIDBOX_Requisitos_y_Requerimientos_Tecnicos.md](file:///c:/Users/Usuario/Dise-o_De_Prototipos/1.KIDBOX_Requisitos_y_Requerimientos_Tecnicos.md) — Requisitos funcionales y de uso.
2. [2.KIDBOX_Diagramas_Bocetos_Diseno_Fisico.md](file:///c:/Users/Usuario/Dise-o_De_Prototipos/2.KIDBOX_Diagramas_Bocetos_Diseno_Fisico.md) — Ergonomía, vista frontal y corte lateral.
3. [3.KIDBOX_Lista_componentes_electrónicos.md](file:///c:/Users/Usuario/Dise-o_De_Prototipos/3.KIDBOX_Lista_componentes_electrónicos.md) — Lista de materiales (BOM) y estados de inventario.
4. [4.KIDBOX_Arquitectura_del_Sistema.md](file:///c:/Users/Usuario/Dise-o_De_Prototipos/4.KIDBOX_Arquitectura_del_Sistema.md) — Arquitectura de hardware, buses, software y GPIO.
