jorgeab21/Dise-o_De_Prototipos/hardware/KIDBOX/netlist.csv

Red | Componente | Pin | Funcion
+3V3 | C2 | 1 | Condensador 100n, pata 1
+3V3 | C3 | 1 | Condensador 100n, pata 1
+3V3 | C4 | 1 | Condensador 10u 25V, pata +
+3V3 | J2 | 16 | RP2350-Plus pin 36 (3V3)
+3V3 | J3 | 1 | Pantalla VCC
+3V3 | J5 | 1 | DAC VIN
+3V3 | TP1 | 1 | Punto de prueba 3V3
BTN_A | J1 | 20 | RP2350-Plus pin 20 (GP15)
BTN_A | SW8 | 1 | Pulsador A, pata 1
BTN_B | J1 | 19 | RP2350-Plus pin 19 (GP14)
BTN_B | SW7 | 1 | Pulsador B, pata 1
BTN_DOWN | J2 | 1 | RP2350-Plus pin 21 (GP16)
BTN_DOWN | SW1 | 1 | Pulsador DOWN, pata 1
BTN_LEFT | J2 | 2 | RP2350-Plus pin 22 (GP17)
BTN_LEFT | SW2 | 1 | Pulsador LEFT, pata 1
BTN_RIGHT | J2 | 5 | RP2350-Plus pin 25 (GP19)
BTN_RIGHT | SW4 | 1 | Pulsador RIGHT, pata 1
BTN_SELECT | J1 | 16 | RP2350-Plus pin 16 (GP12)
BTN_SELECT | SW5 | 1 | Pulsador SELECT, pata 1
BTN_START | J1 | 17 | RP2350-Plus pin 17 (GP13)
BTN_START | SW6 | 1 | Pulsador START, pata 1
BTN_UP | J2 | 4 | RP2350-Plus pin 24 (GP18)
BTN_UP | SW3 | 1 | Pulsador UP, pata 1
GND | C2 | 2 | Condensador 100n, pata 2
GND | C3 | 2 | Condensador 100n, pata 2
GND | C4 | 2 | Condensador 10u 25V, pata -
GND | J1 | 3 | RP2350-Plus pin 3 (GND)
GND | J1 | 8 | RP2350-Plus pin 8 (GND)
GND | J1 | 13 | RP2350-Plus pin 13 (GND)
GND | J1 | 18 | RP2350-Plus pin 18 (GND)
GND | J2 | 3 | RP2350-Plus pin 23 (GND)
GND | J2 | 8 | RP2350-Plus pin 28 (GND)
GND | J2 | 13 | RP2350-Plus pin 33 (AGND)
GND | J2 | 18 | RP2350-Plus pin 38 (GND)
GND | J3 | 2 | Pantalla GND
GND | J5 | 2 | DAC GND
GND | J5 | 6 | DAC SCK
GND | SW1 | 2 | Pulsador DOWN, pata 2
GND | SW2 | 2 | Pulsador LEFT, pata 2
GND | SW3 | 2 | Pulsador UP, pata 2
GND | SW4 | 2 | Pulsador RIGHT, pata 2
GND | SW5 | 2 | Pulsador SELECT, pata 2
GND | SW6 | 2 | Pulsador START, pata 2
GND | SW7 | 2 | Pulsador B, pata 2
GND | SW8 | 2 | Pulsador A, pata 2
GND | SW10 | 2 | Interruptor ON/OFF, C (OFF)
GND | TP2 | 1 | Punto de prueba GND
I2S_BCK | J2 | 6 | RP2350-Plus pin 26 (GP20)
I2S_BCK | J5 | 5 | DAC BCK
I2S_DIN | J2 | 9 | RP2350-Plus pin 29 (GP22)
I2S_DIN | J5 | 4 | DAC DIN
I2S_LRCK | J2 | 7 | RP2350-Plus pin 27 (GP21)
I2S_LRCK | J5 | 3 | DAC LCK
LCD_CS | J1 | 1 | RP2350-Plus pin 1 (GP0)
LCD_CS | J3 | 3 | Pantalla CS
LCD_DC | J1 | 4 | RP2350-Plus pin 4 (GP2)
LCD_DC | J3 | 5 | Pantalla DC
LCD_LED | J2 | 11 | RP2350-Plus pin 31 (GP26)
LCD_LED | J3 | 8 | Pantalla LED
LCD_MOSI | J1 | 5 | RP2350-Plus pin 5 (GP3)
LCD_MOSI | J3 | 6 | Pantalla SDI(MOSI)
LCD_RST | J1 | 2 | RP2350-Plus pin 2 (GP1)
LCD_RST | J3 | 4 | Pantalla RESET
LCD_SCK | J1 | 9 | RP2350-Plus pin 9 (GP6)
LCD_SCK | J3 | 7 | Pantalla SCK
PWR_EN | J2 | 17 | RP2350-Plus pin 37 (3V3_EN)
PWR_EN | SW10 | 1 | Interruptor ON/OFF, comun (B)
(sin conectar) | BT1 | 1 | Bateria, polo + (al conector BAT del RP2350-Plus)
(sin conectar) | BT1 | 2 | Bateria, polo - (al conector BAT del RP2350-Plus)
(sin conectar) | J1 | 6 | RP2350-Plus pin 6 (GP4)
(sin conectar) | J1 | 7 | RP2350-Plus pin 7 (GP5)
(sin conectar) | J1 | 10 | RP2350-Plus pin 10 (GP7)
(sin conectar) | J1 | 11 | RP2350-Plus pin 11 (GP8)
(sin conectar) | J1 | 12 | RP2350-Plus pin 12 (GP9)
(sin conectar) | J1 | 14 | RP2350-Plus pin 14 (GP10)
(sin conectar) | J1 | 15 | RP2350-Plus pin 15 (GP11)
(sin conectar) | J2 | 10 | RP2350-Plus pin 30 (RUN)
(sin conectar) | J2 | 12 | RP2350-Plus pin 32 (GP27)
(sin conectar) | J2 | 14 | RP2350-Plus pin 34 (GP28)
(sin conectar) | J2 | 15 | RP2350-Plus pin 35 (ADC_VREF)
(sin conectar) | J2 | 19 | RP2350-Plus pin 39 (VSYS)
(sin conectar) | J2 | 20 | RP2350-Plus pin 40 (VBUS)
(sin conectar) | J3 | 9 | Pantalla SDO(MISO)
(sin conectar) | J3 | 10 | Pantalla T_CLK
(sin conectar) | J3 | 11 | Pantalla T_CS
(sin conectar) | J3 | 12 | Pantalla T_DIN
(sin conectar) | J3 | 13 | Pantalla T_DO
(sin conectar) | J3 | 14 | Pantalla T_IRQ
(sin conectar) | SW10 | 3 | Interruptor ON/OFF, A (ON, al aire)
