jorgeab21/Dise-o_De_Prototipos/Documentacion/Componentes_DEC_UAI.xlsx

Sheet: Componentes
Catálogo de Componentes — Design Engineering Center (DEC) UAI
Fuente: https://dec.uai.cl/componentes/ · Extraído el 2026-09-25 · 209 componentes
N° | ID Sitio | Familia | Modelo | Función | Especificaciones
 | 417 | Baterías | BRC 18650 battery 6800mah 3.7V Li-ion | Baterías recargables de ion de litio (Li-ion) | Voltaje nominal 3.7 V. Capacidad 6800 mAh
 | 417 | Baterías | NCR 18650B Li-ion | Baterías recargables de ion de litio (Li-ion) | Voltaje nominal 3.6–3.7 V
 | 418 | Módulo | XL6009 | Regulador de voltaje | Voltaje de entrada 3–32 V. Voltaje de salida hasta 35 V
 | 422 | Módulo | HX-2S-A2 | Cargador BMS 18650 2S 5A | BMS para baterías Li-ion 2S. Corriente máxima 5 A. Voltaje de carga 8.4 V
 | 648 | Sensores | SW-420 | Vibración | Voltaje de operación 3.3V/5.0 V. Salida digital: Nivel alto 1 - Nivel bajo 0
 | 649 | Sensores | YG1006 IR | Detectar presencia de fuego mediante radiación infrarroja | Voltaje de operación 3.3 V/5.0 V. Temperatura de trabajo: -25°C a 85 °C
 | 650 | Sensores | RFID-RC522 | Lectura/escritura RFID | Voltaje de operación 3.3 V. Distancia de lectura: 0 a 60mm.
 | 651 | Sensores | AM2302 (DHT22) | Humedad y temperatura | Voltaje 3.3 V/6.0 V. Rango temp: -40°C a 80°C. Rango humedad: 0 a 100% RH
 | 652 | Sensores | Fd10 (Fz0506) | Nivel de agua | Voltaje 3.3 V/5.0 V. Temperatura de trabajo : -30°C a 10°C. Análogo
 | 653 | Sensores | HC-SR04 4 pines | De distancia ultrasónico | Voltaje 5.0 V. Ángulo del sensor: <15 grados. Rango distancia: 2 a 450 cm
 | 654 | Sensores | MH-RD Raindrops module | Presencia e intensidad de lluvia | Voltaje 3.3 V/5.0 V. Señal análoga: Voltaje dependiente de humedad
 | 655 | Sensores | MQ-3 | Detector de Etanol | Voltaje 5.0 V. Señal: Analógica (proporcional a la concentración)
 | 656 | Sensores | MQ-4 | Detector de Metano | Voltaje 5.0 V. Señal: Analógica (proporcional a la concentración)
 | 657 | Sensores | MQ-5 | Detector de GLP y Gas natural | Voltaje 5.0 V. Señal: Analógica (proporcional a la concentración)
 | 658 | Sensores | MQ-6 | Detector de GLP, Propano e Isobutano | Voltaje 5.0 V. Señal: Analógica (proporcional a la concentración)
 | 659 | Sensores | MQ-7 | Detector de Monóxido de carbono | Voltaje 5.0 V. Señal: Analógica (proporcional a la concentración)
 | 660 | Sensores | MQ-8 | Detector de Hidrógeno | Voltaje 5.0 V. Señal: Analógica (proporcional a la concentración)
 | 661 | Sensores | MQ-9 | Detector de CO y gases combustibles | Voltaje 5.0 V. Señal: Analógica (proporcional a la concentración)
 | 662 | Sensores | MQ-135 | Detector de la calidad del aire (NH₃, NOx) | Voltaje 5.0 V. Señal: Analógica (proporcional a la concentración)
 | 663 | Sensores | Pulse sensor | Frecuencia cardíaca | Voltaje 3.3 V/5.0 V. Circuito de cancelación de ruido integrado.
 | 664 | Sensores | Capacitivo v1.2 | Humedad suelo | Voltaje de operación 3.3 V/5.0 V. Salida analógica
 | 665 | Sensores | KY-036 | Detección contacto físico de un dedo o un objeto metálico (cambios en la conductividad) | Voltaje de operación 3.3 V/5.0 V. Salida analógica y digital
 | 666 | Sensores | KY-026 | Sensor infrarrojo de flama | Voltaje de operación 3.3 V/5.0 V. Rango espectral 760–1100 nm
 | 667 | Sensores | MX-RM-5V | Receptor de radiofrecuencia (RF) | Voltaje de operación 5.0 V. Frecuencia 433 MHz
 | 668 | Sensores | KY-001 | Medición de temperatura | Voltaje de operación 3.0–5.5 V. Comunicación 1-Wire
 | 669 | Sensores | GY-530 VL53L0X | Sensor de rango láser de alta precisión basado en la tecnología Time-of-Flight (ToF) | Voltaje de operación 2.6–5.5 V. Rango 30–2000 mm
 | 670 | Sensores | KY-032 | Infrarrojo de evitación de obstáculos | Voltaje de operación 3.3 V/5.0 V. Salida digital
 | 671 | Sensores | DSM501A | Sensor de partículas de polvo PM2.5 | Voltaje de operación 5.0 V. Salida PWM
 | 672 | Sensores | SN04-N | Sensor de proximidad inductivo para metales | Voltaje de operación 5–30 V. Salida digital NPN
 | 673 | Sensores | HM1500LF | Sensor humedad de aire | Voltaje de operación 5.0 V. Rango 0–100 % RH
 | 674 | Sensores | DS18B20 | Sensor de temperatura | Voltaje de operación 3.0–5.5 V. Rango −55 °C a 125 °C
 | 675 | Sensores | LJ12A3-4-Z-BX | Sensor de proximidad inductivo para metales | Voltaje de operación 6–36 V. Distancia de detección 4 mm
 | 676 | Sensores | WZP-PT100 | Sensor de temperatura | Rango −200 °C a 450 °C
 | 677 | Sensores | P35 | Sensor de nivel de agua tipo flotador | Voltaje de operación 5.0 V. Salida analógica
 | 678 | Sensores | YL69 | Humedad suelo | Voltaje de operación 3.3 V/5.0 V. Salida analógica
 | 679 | Sensores | KY-015 (DHT11) | Humedad y temperatura | Voltaje 3.3 V/5.0 V. Rango temp 0–50 °C. Humedad 20–90 % RH
 | 680 | Sensores | HC-SRO4 3 pines (seed) | De distancia ultrasónico | Voltaje 5.0 V. Rango 2–400 cm
 | 681 | Sensores | HC-SR501 | Detector de movimiento (infrarrojo pasivo) | Voltaje de operación 4.5–20 V. Alcance 3–7 m
 | 682 | Sensores | MQ-2 | Detector de gases combustibles y humo | Voltaje de operación 5.0 V. Tiempo de precalentamiento ≥ 20 s
 | 683 | Sensores | Fotorresistencia (LDR) y LM393 | Luz con Fotorresistencia (LDR) | Voltaje de operación 3.3 V/5.0 V. Salida analógica y digital
 | 684 | Sensores | KY-038 | Sensor de sonido de alta sensibilidad | Voltaje de operación 3.3 V/5.0 V. Salida analógica y digital
 | 685 | Sensores | KY-037 | Sensor de sonido de baja sensibilidad | Voltaje de operación 3.3 V/5.0 V. Salida analógica y digital
 | 686 | Sensores | KY-028 | Sensor de temperatura digital | Voltaje de operación 3.3 V/5.0 V. Salida analógica y digital
 | 687 | Sensores | SEN-12642 | Detector de sonido SparkFun | Voltaje de operación 3.3 V/5.0 V. Comunicación digital
 | 688 | Sensores | MH-B | Infrarrojo de evitación de obstáculos | Voltaje de operación 5.0 V
 | 689 | Sensores | KY-039 | Detectar ritmo cardiáco a través del dedo | Voltaje de operación 3.3 V/5.0 V. Salida analógica
 | 690 | Sensores | KY-033 | Seguidor de línea infrarrojo | Voltaje de operación 3.3 V/5.0 V. Salida analógica
 | 691 | Sensores | KY-002 | Vibración e impacto | Voltaje de operación 3.3 V/5.0 V. Salida digital
 | 692 | Sensores | KY-013 | Sensor de temperatura analogo para medir temperatura ambiente | Voltaje de operación 3.3 V/5.0 V. Salida digital
 | 693 | Sensores | SW-520D | Detección de inclinación o vibraciones | Voltaje de operación 3.3 V/5.0 V. Salida digital
 | 694 | Sensores | KY-020 | Detección de inclinación (cierra el circuíto al inclinarse) | Voltaje de operación 3.3 V/5.0 V. Salida digital
 | 695 | Sensores | KY-010 | Interruptor de luz (Fotointerruptor) | Voltaje de operación 3.3 V/5.0 V. Salida digital
 | 696 | Sensores | KY-031 | Impacto, golpe o percusión | Voltaje de operación 3.3 V/5.0 V. Salida analógica y digital
 | 697 | Sensores | KY-022 | Receptor de infrarrojos | Voltaje de operación 3.3 V/5.0 V. Frecuencia 38 kHz
 | 698 | Sensores | KY-018 | Fotorresistor (detecta presencia o ausencia de luz) | Voltaje de operación 3.3 V/5.0 V. Resistencia variable
 | 699 | Sensores | GP2Y0A02YK0F | Sensor de proximidad | Voltaje de operación 4.5–5.5 V. Rango 20–150 cm
 | 700 | Sensores | YF-S201 | Flujo de agua con efecto Hall | Voltaje de operación 5–18 V. Rango de flujo 1–30 L/min
 | 701 | Sensores | Piezoeléctrico | Convierte vibraciones, golpes o presión mecánica en señales eléctricas | Voltaje de operación 1–12 V. Frecuencia resonante 4.6 kHz ±0.5 kHz
 | 702 | Sensores | SEN-10264 | Sensor de flexión | Potencia 0.5 W continua (1 W pico)
 | 703 | Módulo | YL38 | Humedad suelo | Voltaje de operación 3.3 V/5.0 V. Salida analógica
 | 704 | Módulo | SRD-05VDC-SL-C | Relé (relay) de 1 canal de 5V | Voltaje de bobina 5.0 V. Corriente nominal 10 A
 | 705 | Módulo | 8x8 MAX7219 | Matriz puntos LED | Voltaje de operación 5.0 V. Interfaz SPI
 | 706 | Módulo | Seeed Studio LiPo Rider Pro | Administra energía de paneles solares | Voltaje de entrada 3.7 V. Salida USB 5.0 V
 | 707 | Módulo | PAM8403 | Amplificador de audio digital clase D | Voltaje de operación 2.5–5.5 V. Potencia 3 W ×2
 | 708 | Módulo | KY-006 | Zumbadores pasivos | Voltaje de operación 3.3 V/5.0 V
 | 709 | Módulo | Bluethooth HC-05 | Conectividad Bluethooth | Voltaje de operación 3.6–6.0 V. Comunicación UART
 | 710 | Módulo | MH-ET LIVE MAX30102 | Pulsioximetría y monitor de frecuencia cardíaca | Voltaje de operación 1.8 V / 3.3 V. Interfaz I²C
 | 711 | Módulo | Funduino L293D | Manejar motores desde una placa de control sin dañar el microcontrolador. | Voltaje lógico 5.0 V. Voltaje motor hasta 36 V. Puente dual H
 | 712 | Módulo | MH-SD Card Module | Registrar datos, almacenar archivos y otras aplicaciones que requieren memoria externa. | Voltaje de operación 3.3 V/5.0 V. Interfaz SPI
 | 713 | Módulo | FSI1000A | Transmisor de radiofrecuencia (RF) | Voltaje de operación 5.0 V. Frecuencia 433 MHz
 | 714 | Módulo | KY-008 | Transmisor de láser de baja potencia | Voltaje de operación 5.0 V. Potencia óptica 5 mW
 | 715 | Módulo | KY-040 | Medición de posición angular y pulsos | Voltaje de operación 3.3 V/5.0 V. Salida digital. Encoder rotatorio (con pulsador)
 | 716 | Módulo | MH-MINI360 | Conversor de voltaje DC-DC reductor (step-down) | Voltaje de entrada 4.75–23 V. Voltaje de salida ajustable
 | 717 | Módulo | HX711 | Amplificador de celda de carga | Voltaje de operación 2.6–5.5 V. Resolución 24 bits
 | 718 | Módulo | MH-ET LIVE Scanner | Escanear códigos de barra y QR | Voltaje de operación 3.3 V/5.0 V. Comunicación UART
 | 719 | Módulo | DFPlayer Mini MP3-TF-16P | Reproductor de audio compacto y económico | Voltaje de operación 3.2–5.0 V. Soporte microSD (TF). Salida de audio estéreo
 | 720 | Módulo | KY-025 | Detección binaria de campo magnético (interruptor magnético tipo reed switch) | Voltaje de operación 3.3 V/5.0 V. Salida digital (ON/OFF). Proximidad de imán
 | 721 | Módulo | KY-024 | Detección de intensidad de campo magnético (sensor Hall lineal) | Voltaje de operación 3.3 V/5.0 V. Salida analógica proporcional al campo y digital umbral ajustable
 | 722 | Módulo | MAX4466 | Preamplificador de micrófono eléctrico | Voltaje de operación 2.4–5.5 V. Ganancia ajustable
 | 723 | Módulo | MH-Real Time Clock Module - 2 | Reloj en tiempo real | Voltaje de operación 5.0 V. Interfaz I²C
 | 724 | Módulo | MB102 | Fuente de alimentación protoboard | Voltaje de entrada 6.5–12 V. Salidas 3.3 V y 5.0 V
 | 725 | Módulo | KY-003 | Sensor Hall Digital: Detecta presencia de imanes mediante señal ON/OFF. | Voltaje de operación 3.3 V/5.0 V. Salida analógica
 | 726 | Módulo | KY-004 | Interruptor de botón (pulsador) | Voltaje de operación 3.3 V/5.0 V. Salida analógica
 | 727 | Módulo | KY-021 | Interruptor de campo magnético | Voltaje de operación 3.3 V/5.0 V. Salida digital
 | 728 | Módulo | KY-005 | Emisor de infrarrojos | Voltaje de operación 3.3 V/5.0 V. Salida digital
 | 729 | Módulo | KY-027 | Detectar cambios de orientación o vibración | Voltaje de operación 3.3 V/5.0 V. Salida digital. Con LED integrada
 | 730 | Módulo | KY-017 | Detectar movimientos, cambios de posición, vibraciones o inclinaciones | Voltaje de operación 3.3 V/5.0 V. Salida digital
 | 731 | Módulo | HX-53 | Transmitor de infrarrojos | Voltaje de operación 3.3 V/5.0 V. Frecuencia 38 kHz
 | 732 | Módulo | PCB0100 | Transmitor de infrarrojos de 2 canales | Voltaje de operación 3.3 V/5.0 V. Frecuencia 38 kHz
 | 733 | Módulo | Mini DC 5A Motor PWM Speed Controller | Controla la velocidad de un motor de corriente continua (DC) | Voltaje de operación 5–35 V. Corriente máxima 5 A
 | 734 | Módulo | MPU6050 (GY-521) | Acelerometro y giroscopio | Voltaje de operación 3.3–5.0 V. Interfaz I²C
 | 735 | Módulo | TP4056 Mini USB | Cargador lineal para baterías de litio de una celda (3.7V) | Voltaje de entrada 5.0 V (USB). Batería Li-ion 3.7 V (1 celda). Voltaje de carga 4.2 V. Corriente de carga hasta 1 A
 | 736 | Módulo | TP4056 Micro USB | Cargador lineal para baterías de litio de una celda (3.7V) | Voltaje de entrada 5.0 V (USB). Batería Li-ion 3.7 V (1 celda). Voltaje de carga 4.2 V. Corriente de carga hasta 1 A
 | 737 | Módulo | SIM800L | Microchip de comunicación celular que permite a dispositivos electrónicos (como Arduino) enviar SMS, realizar llamadas y conectar a internet 2G mediante comandos | Voltaje de operación 3.7–4.2 V. Redes GSM 2G (850/900/1800/1900 MHz). Comunicación UART
 | 738 | Módulo | RN42XVP-I-RM | Módulo de comunicación Bluetooth 2.1 de bajo consumo | Voltaje de operación 3.0–3.6 V. Bluetooth 2.1 + EDR. Comunicación UART
 | 739 | Módulo | PCF8591 | Puede convertir señales analógicas en digitales (AD) y señales digitales en analógicas (DA) | Voltaje de operación 2.5–6.0 V. Resolución 8 bits
 | 740 | Componentes | Antena helicoidal | Transmisión y recepción de señales de radiofrecuencia (RF) | Impedancia típica 50 Ω. Uso en radiofrecuencia (RF)
 | 741 | Componentes | Tarjeta RFID | Identificación por radiofrecuencia | Frecuencia 13.56 MHz
 | 742 | Componentes | LLavero Tag RFID | Identificación por radiofrecuencia | Frecuencia 13.56 MHz
 | 743 | Componentes | CEET120B085 | Mini parlantes | Voltaje nominal 12 V
 | 744 | Componentes | Mini celda | Panel solar | Voltaje nominal 1.5 V
 | 745 | Componentes | Display 7 segmentos LED | Contador númerico | Voltaje típico 2.0–2.2 V por segmento
 | 746 | Componentes | B10K Grandes | Potenciometros | Resistencia 10 kΩ. Tolerancia ±10%
 | 747 | Componentes | B10K Pequeños | Potenciometros | Resistencia 10 kΩ. Tolerancia ±10%
 | 748 | Componentes | B103 | Potenciometros | Resistencia 10 kΩ. Tolerancia ±20%
 | 749 | Componentes | KY-023 | Eje dual XY PS2 Joystick | Voltaje de operación 3.3 V/5.0 V
 | 750 | Componentes | KY-016 | LED RGB (rojo, verde, azul) | Voltaje de operación 3.3 V/5.0 V
 | 751 | Componentes | KY-034 (CNT5) | LED de destello automático de 7 colores | Diámetro 5 mm
 | 752 | Componentes | EC11 | Encoder rotatorio para detección de giro (potenciometro digital) | Voltaje máximo 5.0 V
 | 753 | Componentes | KY-011 | LED Bicolor | Diámetro 5 mm
 | 754 | Componentes | KY-029 | LED Bicolor | Diámetro 3 mm
 | 755 | Componentes | LED RGB 140C05 | LED RGB (rojo, verde, azul) | Diámetro 10 mm
 | 756 | Componentes | KY-009 | LED SMD RGB | Voltaje de operación 3.3 V/5.0 V
 | 757 | Componentes | PCB modificadas |  | Con cuatro interruptores
 | 758 | Componentes | 3.5 inch RPI Display | Pantalla touch LCD | Voltaje de operación 5.0 V
 | 759 | Componentes | NX3224T024 | Pantalla touch LCD | Tamaño 2.4 pulgadas. Voltaje 3.3 V/5.0 V
 | 760 | Componentes | Shield TFT Touch | Pantalla touch LCD | Voltaje de operación 5.0 V
 | 761 | Componentes | Microswitch V-156-1C25 | 2 pines funciona como un interruptor simple de tipo ON/OFF (encendido/apagado) Interruptor de acción rápida | Voltaje nominal 250 VAC
 | 762 | Componentes | Battery Shield 18650 (Doble Pila) | Fuente de alimentación portátil | Voltaje de salida 5.0 V
 | 763 | Componentes | Battery Shield 18650 (Una Pila) | Fuente de alimentación portátil | Voltaje de salida 5.0 V
 | 764 | Componentes | VN-2252 | Ventilador compacto | Voltaje nominal 12 V. Dimensiones 40 × 40 × 20 mm
 | 765 | Componentes | Botón Sanwa OBSF-24 | Botón pulsador | Diámetro 24 mm
 | 766 | Componentes | AFC0612D | Ventilador compacto | Voltaje nominal 12 V. Dimensiones 60 × 60 × 25 mm
 | 767 | Componentes | Botón Arcade 24mm | Botón pulsador | Diámetro 24 mm
 | 768 | Componentes | Válvula solenoide | Controla flujo de líquidos o gases | Voltaje nominal 12 V
 | 769 | Componentes | Brushless Fan Pengdalantu | Ventilador compacto | Voltaje nominal 5.0 V. Dimensiones 30 × 30 × 10 mm
 | 770 | Componentes | Brushless Fan Caizhu Fan | Ventilador compacto | Voltaje nominal 12 V. Dimensiones 50 × 50 × 10 mm
 | 771 | Componentes | LYF Sleeve | Ventilador compacto | Voltaje nominal 5.0 V. Dimensiones 80 × 80 × 10 mm
 | 772 | Componentes | CC DC0-18V | Mini generador hidroeléctrico que convierte la energía potencial del agua en energía eléctrica de corriente continua | Voltaje ajustable 0–18 V
 | 773 | Componentes | FJ60D12C3 Fulree | Conversor de voltaje DC/DC | Voltaje de operación 20–60 V
 | 774 | Componentes | Portapilas para baterías AA (4 pilas) | 4 pilas AA | Voltaje de salida 6.0 V
 | 775 | Componentes | Portapilas para baterías AA (2 pilas) | 1 pila AA | Voltaje de salida 3.0 V
 | 776 | Componentes | Portapilas para baterías AA (1 pilas) | 2 pila AA | Voltaje de salida 1.5 V
 | 777 | Componentes | LCD 1602 azul | Pantalla LCD 1602 azul | Voltaje de operación 5.0 V
 | 778 | Componentes | OLED 0.96 pulgadas | Pantalla 0.96 pulgadas | Voltaje de operación 3.3 V/5.0 V
 | 779 | Componentes | OLED 0.91 pulgadas | Pantalla 0.91 pulgadas | Voltaje de operación 3.3 V/5.0 V
 | 780 | Componentes | 1.54 inch E-paper module | Pantalla de tinta electronica MH-ET LIVE | Voltaje de operación 3.3 V
 | 781 | Componentes | NEO-7M-0-000 | GPS Brújula | Voltaje de operación 3.0–5.0 V
 | 782 | Componentes | Botón arcade A4 Switch colores | Interruptor mecánico momentáneo | Voltaje máximo 250 VAC
 | 783 | Componentes | XH-M239 | Probador de capacidad de baterías de litio | Diseñado para baterías de litio 18650
 | 784 | Placas | PCB con Arduino RedBeard
 | 785 | Placas | Arduino UNO | Prototipado y control básico de sistemas electrónicos | Voltaje de operación 5.0 V. Microcontrolador ATmega328P
 | 786 | Placas | ESP8266MOD | Unicamente WIFI | Voltaje de operación 3.3 V. Conectividad WiFi
 | 787 | Placas | ESP32 | Con Bluethooth y WIFI | Voltaje de operación 3.3 V. Conectividad WiFi y Bluetooth
 | 788 | Placas | Crowduino | Placa compatible con Arduino UNO | Voltaje de operación 5.0 V. Compatible con Arduino UNO
 | 789 | Placas | Arduino Leonardo | Permite conectarse al computador y funcionar como teclado o mouse | Voltaje de operación 5.0 V. Microcontrolador ATmega32U4
 | 790 | Placas | Arduino Pro Micro | Emulación teclado/control/mouse compacta | Voltaje de operación 5.0 V. Microcontrolador ATmega32U4
 | 791 | Placas | Arduino Nano 33 Ble | Proyectos IoT y wearables, Proyectos conectados por Bluetooth, como relojes o sensores | Voltaje de operación 3.3 V. Conectividad Bluetooth Low Energy
 | 792 | Placas | Arduino doc 2 | WIFI, Equipo que conecta sensores a internet (Gateway IoT) | Voltaje de operación 5.0 V
 | 793 | Placas | Raspberry Pi Pico | Flexible sin conectividad inalámbrica | Voltaje de operación 3.3 V. Microcontrolador RP2040
 | 794 | Placas | Raspberry Pi Pico W | Con Bluethooth y WIFI | Voltaje de operación 3.3 V. Microcontrolador RP2040. Conectividad WiFi
 | 795 | Placas | Raspberry Pi Zero 1.3 | Mini computador para proyectos pequeños | Voltaje de operación 5.0 V
 | 796 | Placas | Raspberry Pi 3 Model B+ | Versátil, es como un PC (ideal juegos/robótica) | Voltaje de operación 5.0 V. Conectividad WiFi y Ethernet
 | 797 | Placas | ESP32 MOD UAI | Sensor de humedad y temperatura, giroscópio | Voltaje de operación 3.3 V. Conectividad WiFi y Bluetooth
 | 798 | Placas | RedBearLab Blend Micro v1.0 | Proyectos Bluetooth Low Energy | Voltaje de operación 3.3 V. Conectividad Bluetooth Low Energy
 | 799 | Placas | Teensy 4.0 | Procesamiento de alta velocidad | Voltaje de operación 3.3 V. Microcontrolador ARM Cortex-M7
 | 800 | Placas | Teensy 4.1 | Procesamiento de alta velocidad | Voltaje de operación 3.3 V. Microcontrolador ARM Cortex-M7
 | 801 | Prototipado | Protoboard 170 | Base pruebas | Número de puntos 170
 | 802 | Prototipado | Protoboard 400 | Base pruebas | Número de puntos 400
 | 803 | Prototipado | Protoboard 800 | Base pruebas | Número de puntos 800
 | 804 | Kit | Pack Higométrico (YL38/YL69) | Humedad Suelo | Voltaje de operación 3.3 V/5.0 V
 | 805 | Kit | Pack MH-RD Raindrops module | Presencia e intensidad de lluvia | Voltaje de operación 3.3 V/5.0 V
 | 806 | Kit | Raspberry Pi Zero 2 Barnones Kit | Mini computador para proyectos pequeños | Voltaje de operación 5.0 V
 | 807 | Kit | Kit Raspberry Pi 3 Model B+ | Con la camara | Voltaje de operación 5.0 V
 | 808 | Kit | Arduino LilyPad Protosnap Plus Kit | Kit de prototipado de electrónica cosible (e-textil) | 1 boton, 8 LEDs, 1 switch, 1 bateria, 1 buzzer, 1 bateria, 1 light sensor, 1 rollo de hilo.
 | 809 | Kit | MD-TSW-20M (modulo) y TSW-20M (sensor) | Sensor de Turbidez de liquidos | Voltaje de operación 5.0 V
 | 810 | Kit | PT1000-RTD Platino y RTD PT100 | Sensor de temperatura y transmisor que convierte la señal del sensor | RTD PT100 y PT1000
 | 811 | Kit | Kit de SM-S3317SR | Servomotor de rotación continua y sets de engranajes | Voltaje de operación 5.0 V
 | 812 | Kit | Kit componentes servomotores desordenados | Kit para servomotores, tales como engranajes | Voltaje de operación 4.8–6.0 V
 | 813 | Kit | Pack Olimex Shield EKG/EMG | Permite capturar señales de electrocardiografía (EKG) y electromiografía (EMG) | Compatibilidad con placas Arduino
 | 814 | Celda de carga | 50 Kg | Transductor | Capacidad máxima 50 kg
 | 815 | Celda de carga | 5 Kg | Transductor | Capacidad máxima 5 kg
 | 816 | Celda de carga | 2 Kg | Transductor | Capacidad máxima 2 kg
 | 817 | Bomba | Mini bomba de agua sumergible | Convierte energía eléctrica en movimiento de agua. | Voltaje de operación 3.0–6.0 V
 | 818 | Bomba | Javtop JT-280T | Bomba de agua sumergible impulsa, traslada y eleva agua | Voltaje de operación DC 6–18 V
 | 819 | Baterías | PAW-68 | Batería/cargador portatil | Voltaje nominal 3.7 V
 | 820 | Baterías | Batería 9V | Baterías recargables de ion de litio (Li-ion) | Voltaje nominal 9.0 V
 | 821 | Baterías | Batería De Lithium Ion 300mah 4.6v Litio | Baterías recargables de ion de litio (Li-ion) | Voltaje nominal 4.6 V. Capacidad 300 mAh
 | 822 | Baterías | Batería Gens ACE 2200 mAh | Baterías para drones | Voltaje nominal 11.1 V. Capacidad 2200 mAh
 | 823 | Motor | ROB-11696 | Motor de corriente continua | Voltaje de operación 3.0 V
 | 824 | Motor | WS-25GA370R | Motorreductor de corriente continua | Voltaje de operación 6–12 V
 | 825 | Motor | 17pm k374bn02cn | Motor paso a paso bipolar | Voltaje de operación 12 V
 | 826 | Motor | 28BYJ-48 | Motor paso a paso 4 fases | Voltaje de operación 5.0 V
 | 827 | Motor | RK-500TB | Motor de husillo redonde de CC | Voltaje de operación 6–12 V
 | 828 | Motor | SG90 | Servomotor ideal para aplicaciones de bajo torque y peso, especialmente en proyectos educativos y de prototipado | Voltaje de operación 4.0–7.2 V
 | 829 | Motor | Motorreductor DC amarillo | TT motor | Voltaje de operación 3–6 V
 | 830 | Motor | 49TYD-5E 10 | Motor sincrono de corriente alterna | Voltaje de operación 220–240 VAC
 | 831 | Motor | GS-3630BB | Servomotor analógico estándar | Voltaje de operación 4.8–6.0 V. Torque 3.0–6.5 kg·cm
 | 832 | Motor | MG996R | Servomotor estándar | Voltaje de operación 6.0 V. Torque 11 kg·cm
 | 833 | Motor | MG995 | Servomotor digital | Voltaje de operación 4.8–6.0 V. Torque 10–15 kg·cm
 | 834 | Motor | SM-430R | Servomotor de rotación continua | Voltaje de operación 4.8–6.0 V. Torque 3.3–5.1 kg·cm
 | 835 | Motor | GM-5509MG | Servomotor estándar | Voltaje de operación 4.8–6.0 V. Torque 8.65–9.35 kg·cm
 | 836 | Motor | S05NF STD | Servomotor mini | Voltaje de operación 4.8–6.0 V. Torque 2.8–3.2 kg·cm
 | 837 | Motor | SM-S3317SR | Servomotor de rotación continua | Voltaje de operación 4.8 V. Torque 2.1 kg·cm
 | 838 | Motor | GS-9018MG | Servomotor mini | Voltaje de operación 4.8–6.0 V
 | 839 | Cables | Cargador Bateria 9V | Permite recargar baterías de 9 V | Voltaje de salida 9.0 V
 | 840 | Cables | Enchufe USB A doble | Proporciona dos salidas USB tipo A para alimentar o cargar dispositivos | Voltaje de salida 5.0 V. Corriente máxima 1.2 A
 | 841 | Cables | Enchufe USB-A y C (Quick Charge) | Permite cargar dispositivos mediante USB-A o USB-C con soporte de carga rápida | Quick Charge 3.0
 | 842 | Cables | RY-0530 | Permite cargar dispositivos mediante conector micro-USB | Voltaje de operación 5.0 V
 | 843 | Cables | TSY-0530 | Permite cargar dispositivos mediante micro-USB con control ON/OFF | Voltaje de operación 5.0 V
 | 844 | Cables | USB-microUSB (largos) | Permite alimentar y transferir datos entre USB y micro-USB | Voltaje de operación 5.0 V
 | 845 | Cables | USB-MicroUSB (cortos) | Permite alimentar y transferir datos entre USB y micro-USB en conexiones cortas | Voltaje de operación 5.0 V
 | 846 | Cables | USB-TipoB | Permite alimentar y transferir datos entre USB tipo A y tipo B | Voltaje de operación 5.0 V
 | 847 | Cables | USB-TipoC | Permite alimentar y transferir datos entre dispositivos con conector USB-C | Voltaje de operación 5.0 V
 | 848 | Cables | Auxiliar | Permite transmitir señales de audio analógicas | Señal de audio analógica
 | 849 | Cables | USB-mini-micro-TipoB | Permite alimentar y transferir datos entre conectores USB mini, micro y tipo B | Voltaje de operación 5.0 V
 | 850 | Cables | VGA (hembra-hembra) | Permite extender o interconectar cables VGA para señal de video analógica | Señal de video analógica
 | 851 | Cables | Banana-Caimán | Permite realizar conexiones temporales para pruebas y mediciones eléctricas | Conectores tipo banana y caimán
 | 852 | Robot | Zumo Robot v1.2 | Plataforma robótica móvil para aprendizaje y experimentación | Controlador integrado, motores DC, sensores básicos

Sheet: Resumen por familia
Resumen por familia
Familia | Cantidad de componentes | % del total
Baterías
Bomba
Cables
Celda de carga
Componentes
Kit
Motor
Módulo
Placas
Prototipado
Robot
Sensores
Total
