jorgeab21/Dise-o_De_Prototipos/(list of files, cad)

Other CAD files:
hardware/Diseño 3D/KIDBOX_BACKUP.f3z
hardware/Diseño 3D/KIDBOX_ENSAMBLE_COMPLETO_v1.f3z
