jorgeab21/Dise-o_De_Prototipos/hardware/KIDBOX/verificacion/3d_bottom.png

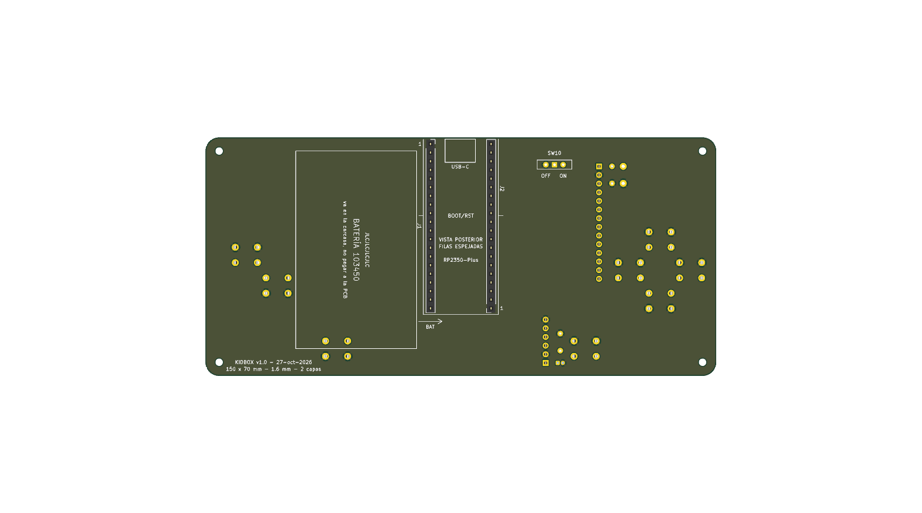
hardware/KIDBOX/verificacion/3d_bottom.png
