jorgeab21/Dise-o_De_Prototipos/hardware/KIDBOX/verificacion/prueba_1a1_v09_escala_alto.jpg

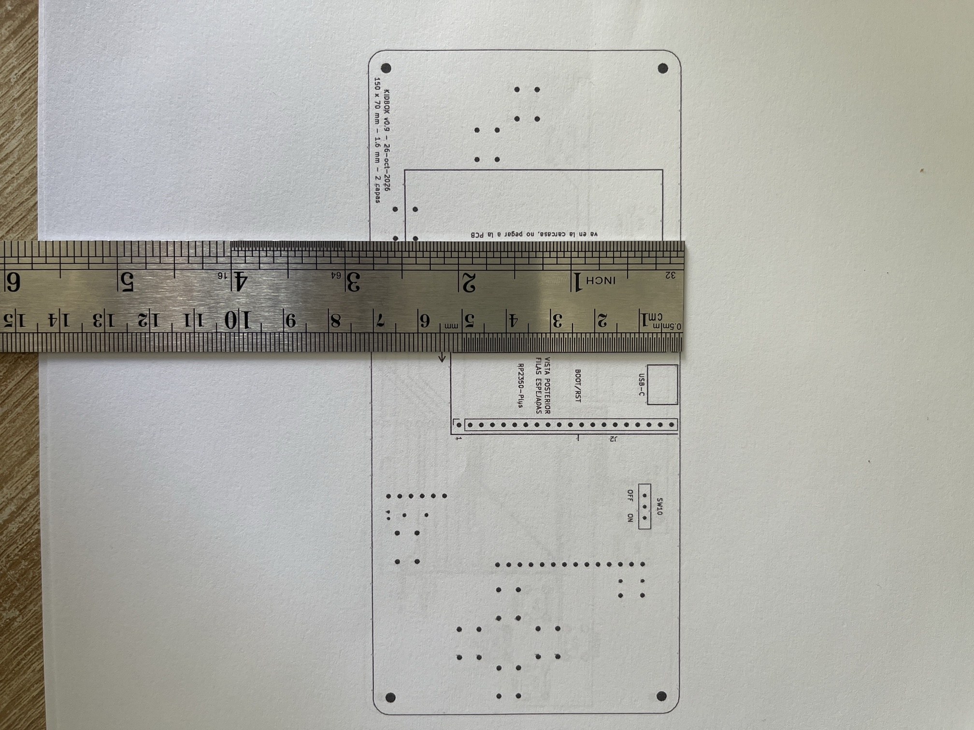
hardware/KIDBOX/verificacion/prueba_1a1_v09_escala_alto.jpg
