jorgeab21/Dise-o_De_Prototipos/hardware/fabricacion/KIDBOX_1a1_frente.pdf

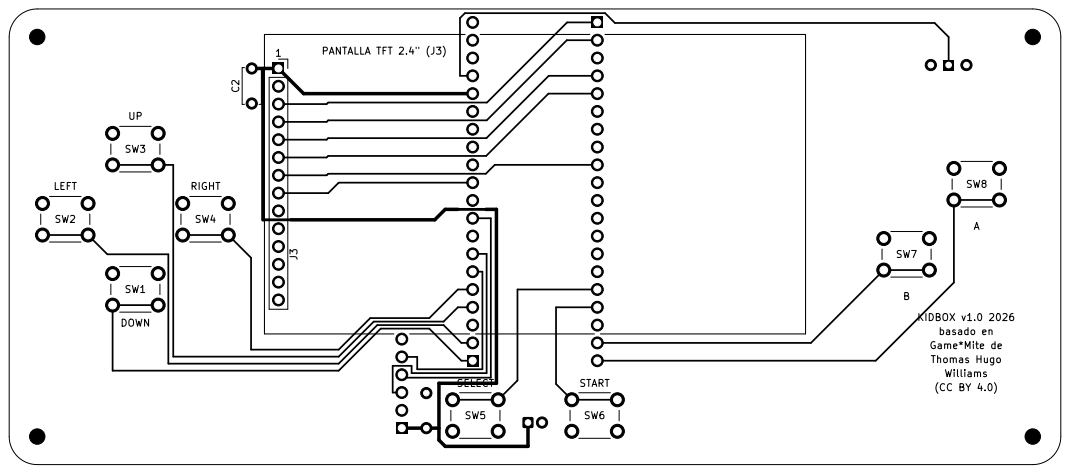
[picture p8: page 1]

KIDBOX v1.0 2026
basado en Game*Mite de
