jorgeab21/Dise-o_De_Prototipos/hardware/fabricacion/KIDBOX_1a1_reverso.pdf

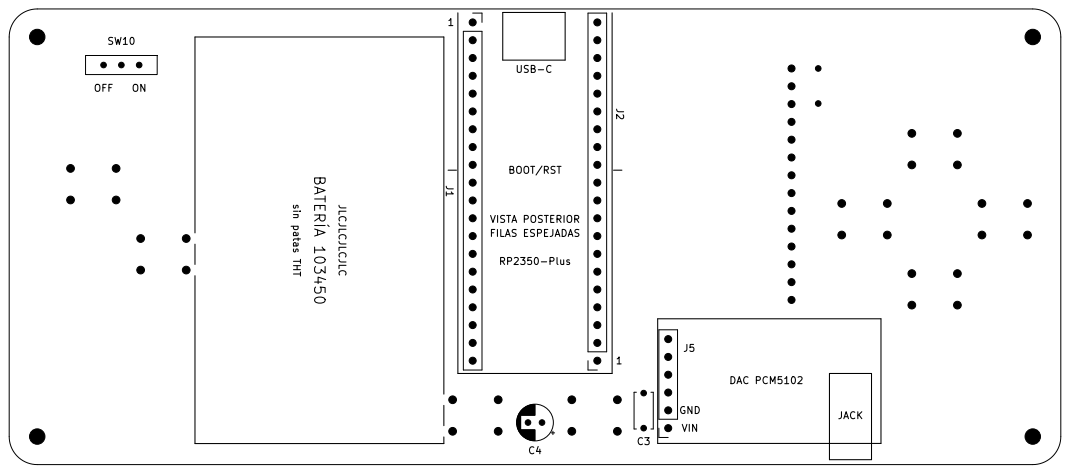
[picture p9: page 1]

VIN 1 BOOT/RST VISTA POSTERIOR
