jorgeab21/Dise-o_De_Prototipos/hardware/KIDBOX/KIDBOX.kicad_pcb

## KiCad design hardware/KIDBOX/KIDBOX.kicad_pcb (2026-10-29)

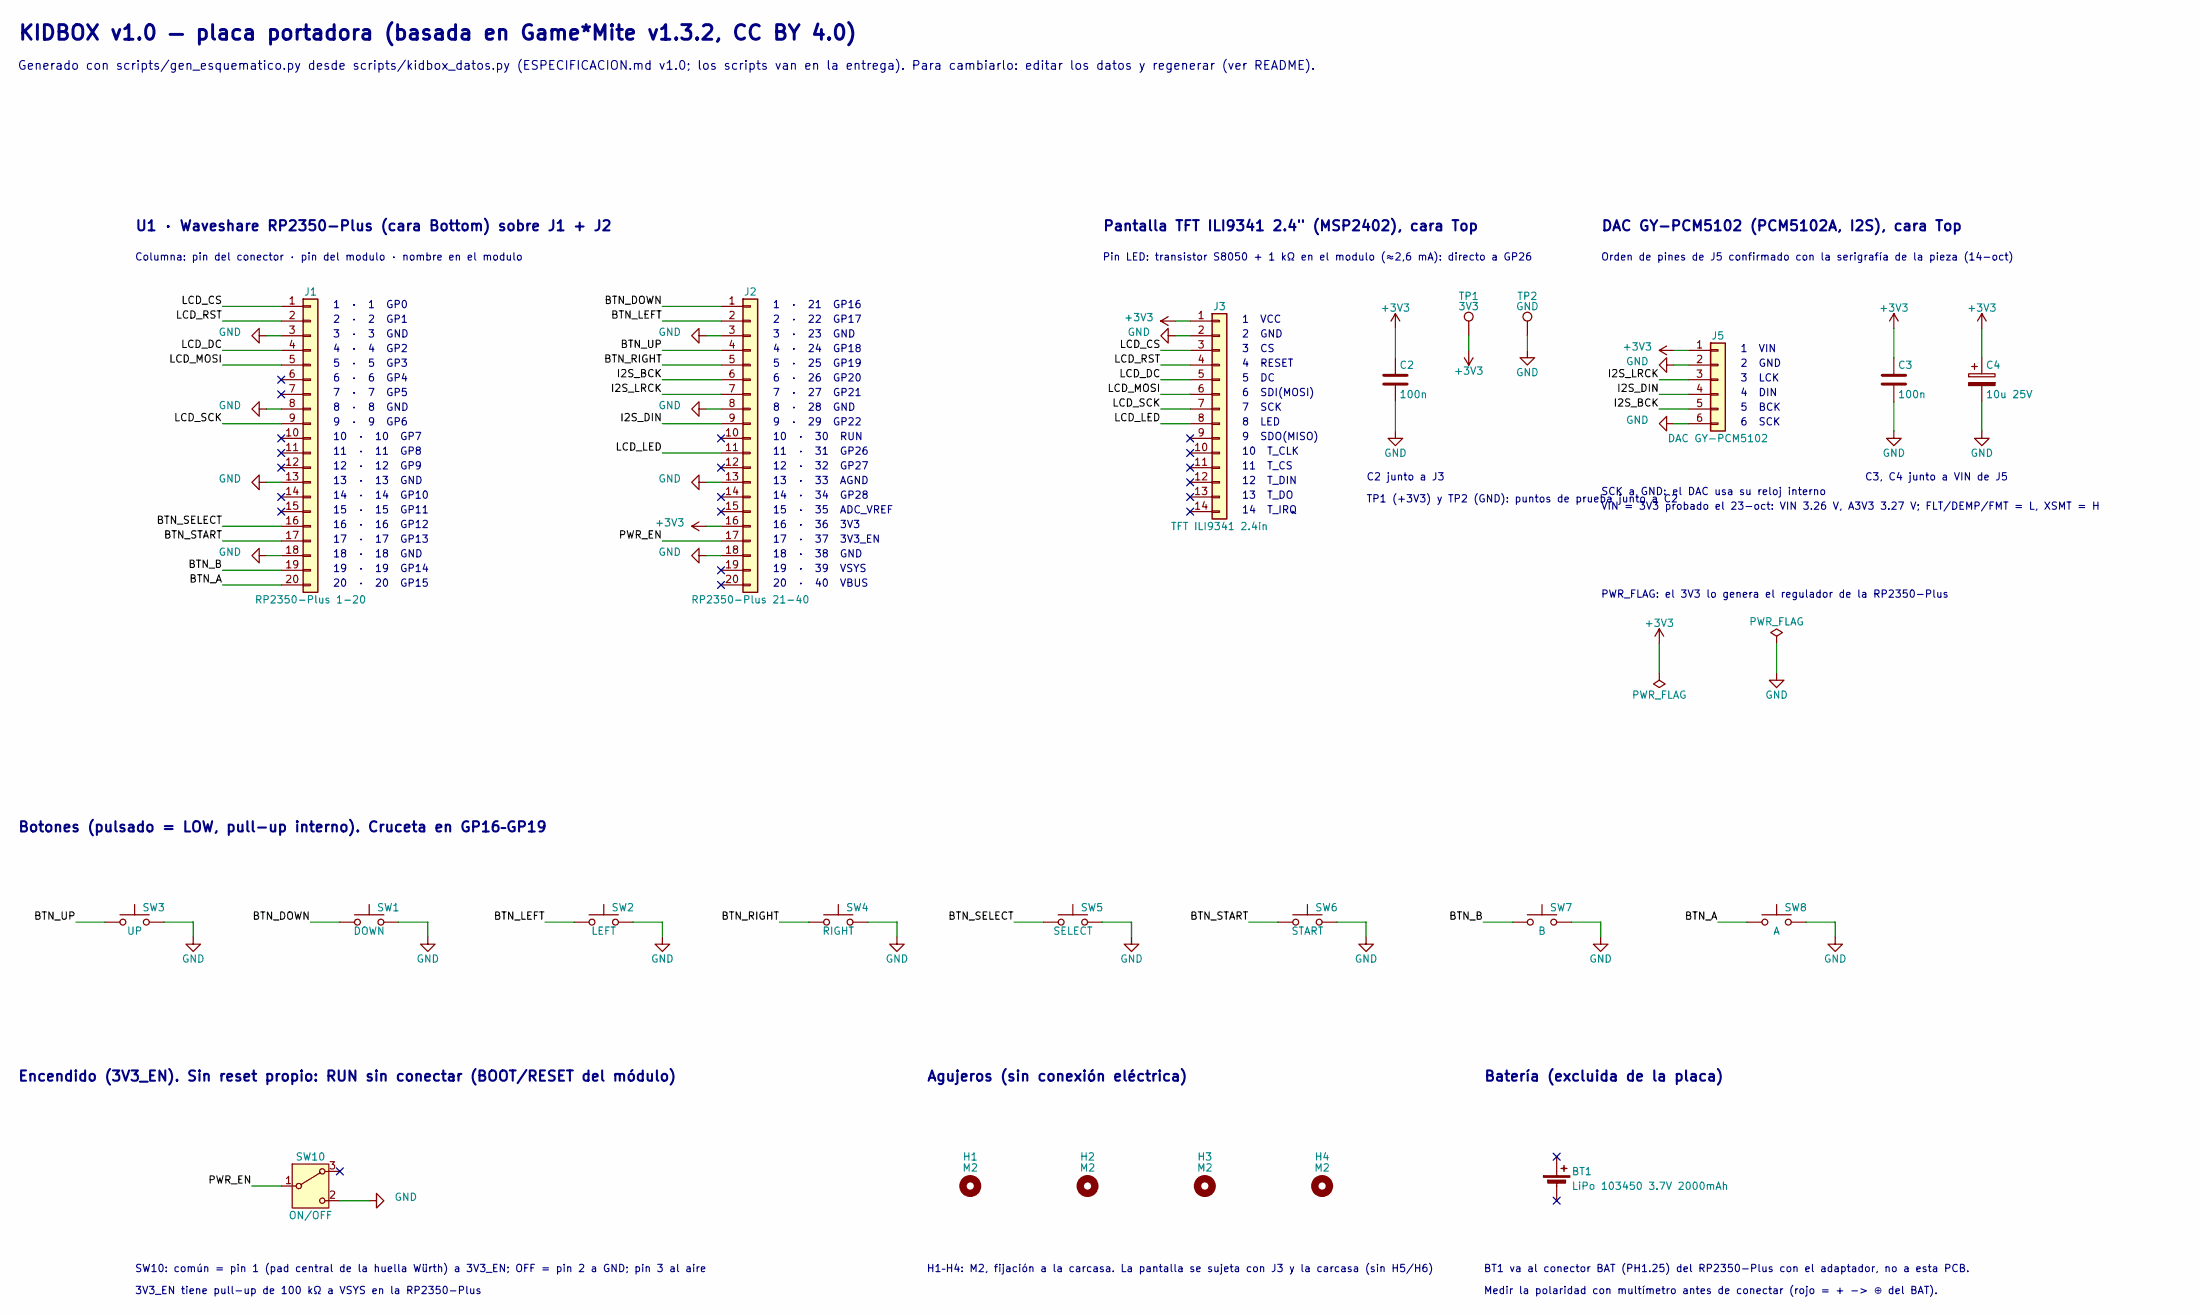
[picture p10: schematic KIDBOX.kicad_sch]

Parts:
BT1: LiPo 103450 3.7V 2000mAh
C2, C3: 100n; C_Disc_D5.0mm_W2.5mm_P5.00mm
C4: 10u 25V; CP_Radial_D4.0mm_P1.50mm
H1, H2, H3, H4: M2; MountingHole_2.2mm_M2
J1: RP2350-Plus 1-20; PinSocket_1x20_P2.54mm_Vertical
J2: RP2350-Plus 21-40; PinSocket_1x20_P2.54mm_Vertical
J3: TFT ILI9341 2.4in; PinSocket_1x14_P2.54mm_Vertical
J5: DAC GY-PCM5102; GY-PCM5102_1x06_P2.54mm
SW1: DOWN; SW_PUSH_6mm
SW2: LEFT; SW_PUSH_6mm
SW3: UP; SW_PUSH_6mm
SW4: RIGHT; SW_PUSH_6mm
SW5: SELECT; SW_PUSH_6mm
SW6: START; SW_PUSH_6mm
SW7: B; SW_PUSH_6mm
SW8: A; SW_PUSH_6mm
SW10: ON/OFF; SW_Slide-03_Wuerth-WS-SLTV_10x2.5x6.4_P2.54mm
TP1: 3V3; TestPoint_THTPad_D2.0mm_Drill1.0mm
TP2: GND; TestPoint_THTPad_D2.0mm_Drill1.0mm

Connections:
+3V3: C2.1, C3.1, C4.1, J2.16, J3.1, J5.1, TP1.1
/BTN_A: J1.20, SW8.1
/BTN_B: J1.19, SW7.1
/BTN_DOWN: J2.1, SW1.1
/BTN_LEFT: J2.2, SW2.1
/BTN_RIGHT: J2.5, SW4.1
/BTN_SELECT: J1.16, SW5.1
/BTN_START: J1.17, SW6.1
/BTN_UP: J2.4, SW3.1
/I2S_BCK: J2.6, J5.5
/I2S_DIN: J2.9, J5.4
/I2S_LRCK: J2.7, J5.3
/LCD_CS: J1.1, J3.3
/LCD_DC: J1.4, J3.5
/LCD_LED: J2.11, J3.8
/LCD_MOSI: J1.5, J3.6
/LCD_RST: J1.2, J3.4
/LCD_SCK: J1.9, J3.7
/PWR_EN: J2.17, SW10.1 (B)
GND: C2.2, C3.2, C4.2, J1.3, J1.8, J1.13, J1.18, J2.3, J2.8, J2.13, J2.18, J3.2, J5.2, J5.6, SW1.2, SW2.2, SW3.2, SW4.2, SW5.2, SW6.2, SW7.2, SW8.2, SW10.2 (C), TP2.1

Notes on the sheet:
KIDBOX v1.0 — placa portadora (basada en Game*Mite v1.3.2, CC BY 4.0)
Generado con scripts/gen_esquematico.py desde scripts/kidbox_datos.py (ESPECIFICACION.md v1.0; los scripts van en la entrega). Para cambiarlo: editar los datos y regenerar (ver README).
U1 · Waveshare RP2350-Plus (cara Bottom) sobre J1 + J2
Columna: pin del conector · pin del modulo · nombre en el modulo
1 · 1 GP0
2 · 2 GP1
3 · 3 GND
4 · 4 GP2
5 · 5 GP3
6 · 6 GP4
7 · 7 GP5
8 · 8 GND
9 · 9 GP6
10 · 10 GP7
11 · 11 GP8
12 · 12 GP9
13 · 13 GND
14 · 14 GP10
15 · 15 GP11
16 · 16 GP12
17 · 17 GP13
18 · 18 GND
19 · 19 GP14
20 · 20 GP15
1 · 21 GP16
2 · 22 GP17
3 · 23 GND
4 · 24 GP18
5 · 25 GP19
6 · 26 GP20
7 · 27 GP21
8 · 28 GND
9 · 29 GP22
10 · 30 RUN
11 · 31 GP26
12 · 32 GP27
13 · 33 AGND
14 · 34 GP28
15 · 35 ADC_VREF
16 · 36 3V3
17 · 37 3V3_EN
18 · 38 GND
19 · 39 VSYS
20 · 40 VBUS
Pantalla TFT ILI9341 2.4" (MSP2402), cara Top
Pin LED: transistor S8050 + 1 kΩ en el modulo (≈2,6 mA): directo a GP26
1 VCC
2 GND
3 CS
4 RESET
5 DC
6 SDI(MOSI)
7 SCK
8 LED
9 SDO(MISO)
10 T_CLK
11 T_CS
12 T_DIN
13 T_DO
14 T_IRQ
C2 junto a J3
TP1 (+3V3) y TP2 (GND): puntos de prueba junto a C2
DAC GY-PCM5102 (PCM5102A, I2S), cara Top
Orden de pines de J5 confirmado con la serigrafía de la pieza (14-oct)
1 VIN
3 LCK
4 DIN
5 BCK
6 SCK
SCK a GND: el DAC usa su reloj interno
C3, C4 junto a VIN de J5
VIN = 3V3 probado el 23-oct: VIN 3.26 V, A3V3 3.27 V; FLT/DEMP/FMT = L, XSMT = H
PWR_FLAG: el 3V3 lo genera el regulador de la RP2350-Plus
Botones (pulsado = LOW, pull-up interno). Cruceta en GP16–GP19
Encendido (3V3_EN). Sin reset propio: RUN sin conectar (BOOT/RESET del módulo)
SW10: común = pin 1 (pad central de la huella Würth) a 3V3_EN; OFF = pin 2 a GND; pin 3 al aire
3V3_EN tiene pull-up de 100 kΩ a VSYS en la RP2350-Plus
Agujeros (sin conexión eléctrica)
H1–H4: M2, fijación a la carcasa. La pantalla se sujeta con J3 y la carcasa (sin H5/H6)
Batería (excluida de la placa)
BT1 va al conector BAT (PH1.25) del RP2350-Plus con el adaptador, no a esta PCB.
Medir la polaridad con multímetro antes de conectar (rojo = + -> ⊕ del BAT).

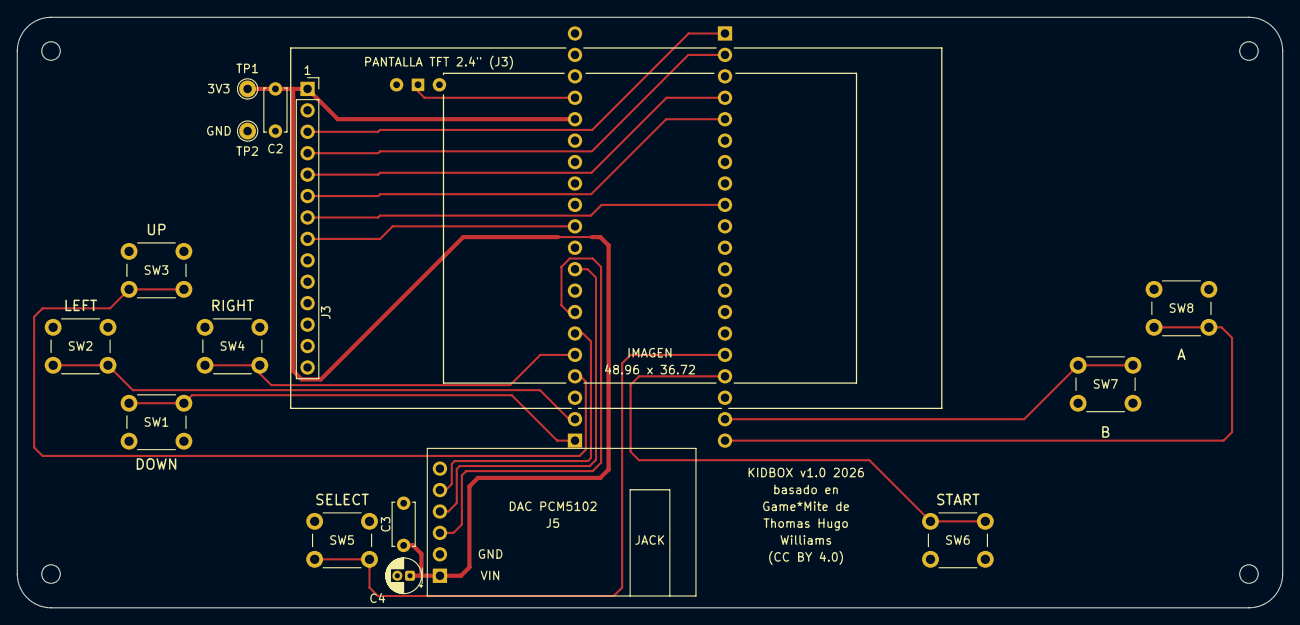
[picture p11: board KIDBOX.kicad_pcb from above]

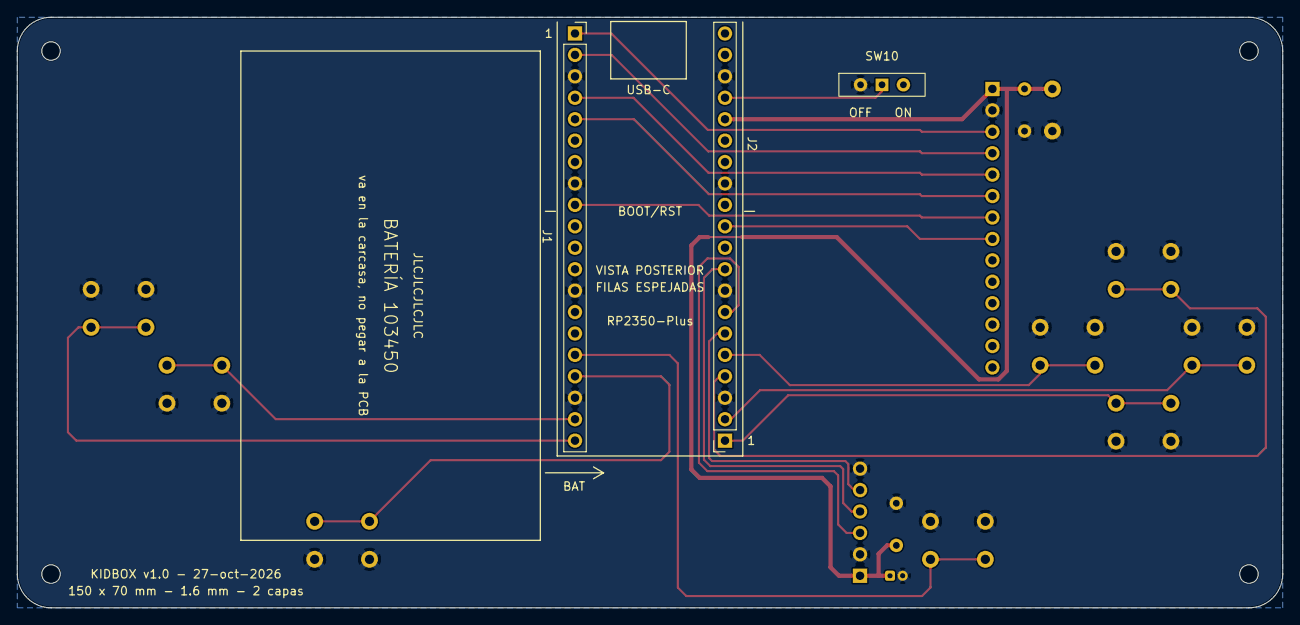
[picture p12: board KIDBOX.kicad_pcb from below]

Board: 2 copper layers, 150.0 x 70.0 mm, 22 parts (3 on the bottom side), 20 nets.
