jorgeab21/Dise-o_De_Prototipos/(commit log)

2026-10-01 Agrega BOM preliminar Fase 1
2026-10-02 Agrega propuesta KIDBOX en Markdown y carpeta de documentacion
2026-10-13 README: carta de presentacion, problemas, propuesta e indice del trabajo
2026-10-13 Plantilla del profe + borrador de especificacion
2026-10-13 Especificacion v0.5: respuestas a la Fase 0 y layout actualizado
2026-10-13 Especificacion v0.6: datos confirmados con hojas oficiales, riesgo de carga 1 A, layout actualizado
2026-10-13 Actualizacion de BOM
2026-10-13 Fase 1: esquematico KIDBOX revisado (ERC 0 errores), BOM, netlist y scripts
2026-10-13 BOM Final
2026-10-13 Entregable semana 10. falta PCB y GERBER
2026-10-13 Correcciones entregable Semana 10: alineado con esquematico y especificacion v0.6
    - Docs 1-4: 9 pulsadores (incluye RESET), ON/OFF recto en la cara posterior a 3V3_EN,
    pines reales del esquematico, cargador ETA6096 conmutado, tactil y SD sin cablear en la PCB.
    - Doc 2: vista frontal y corte lateral corregidos segun el layout de la PCB.
    - Doc 3: BOM con cantidades exactas (tiras, pasivos, M3, capuchones, tira macho 1x4).
    - Doc 6: hitos del curso (16-oct, 30-oct, 06-nov, 13-nov) y riesgo de carga a 1 A.
    - README: links reparados tras mover KIDBOX.md y el PDF a Documentacion/, indice Semana 10.
    Quedan en pausa para el equipo: catalogo de juegos, responsables y fechas del plan, bateria.
    Co-A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
2026-10-14 Especificacion v0.7: medidas reales, sin RESET frontal, bateria 2000 mAh, layout reordenado
2026-10-14 Fase 1 v0.7: sin RESET frontal (SW9, C1), sin J4, SW10 con huella Wuerth 2.54 mm
    - RUN (pin 30) queda no_connect; se elimina la red RUN.
    - SW10: simbolo Switch:SW_SPDT_312 (comun = pin 1 = pad central de la huella
    SW_Slide-03_Wuerth-WS-SLTV_10x2.5x6.4_P2.54mm), pad 2 a GND, pad 3 sin conectar.
    - J5: orden de pines confirmado, sin [SUPUESTO].
    - ESPECIFICACION.md actualizada por el alumno (seccion 4 y 6).
    - ERC 0 errores, BOM.csv y netlist.csv regenerados.
2026-10-14 Fase 2 PCB KIDBOX + correcciones de revision (sin H5/H6, SELECT/START a 66.5/83.5)
    - scripts/gen_pcb.py: PCB completo generado con pcbnew (contorno 150x65 r4,
    H1-H4, huellas oficiales en las posiciones de la seccion 6, 0 vias, pistas
    en F.Cu, plano GND continuo en B.Cu con alivios termicos, serigrafia).
    - J5 con VIN a la derecha visto de frente (I2S sin cruces ni vias); 3V3 a
    VIN por un puente pad a pad en B.Cu; PWR_EN por el borde superior.
    - Revision del alumno: se eliminan H5/H6 y la regla de KIDBOX.kicad_dru;
    SW5/SW6 a x = 66.5 / 83.5 para sacar el cobre de START de la zona de bateria.
    - verificar.py: ERC 0, DRC 0 errores / 0 avisos, 0 sin conectar, paridad 0.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
2026-10-14 Fase 4: fabricacion PRELIMINAR
    Paquete para JLCPCB (2 capas) en fabricacion/: Gerbers, taladros Excellon
    (PTH/NPTH separados, origen absoluto, mapas PDF), KIDBOX_gerbers_PRELIMINAR.zip
    y PDF 1:1 de frente y reverso; README.md con el aviso PRELIMINAR - NO FABRICAR,
    orden de soldadura, parametros de pedido y revision en el visor.
    Incluye las correcciones de la Fase 3 (rondas 2 y 3): DAC horizontal (J5 en
    x = 59, C3/C4, I2S y 3V3 re-ruteados, sin pistas en B.Cu), min_connection 0.2,
    C4 10u 25V, huellas con hoja/filtros/unidades (F8 sin cambios), OFF/ON en SW10,
    KIDBOX/.history/ en .gitignore, verificar_extra.py y la especificacion
    actualizada por el alumno. El .kicad_pcb no cambio en la Fase 4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
2026-10-14 Fase 4: BOM al dia y ubicacion del numero de pedido
    - BOM: nota de SW10 "paso 2.54 mm confirmado en protoboard (14-oct)";
    DECISIONES.md marca como resueltos el paso de SW10 y el orden de J5.
    - B.SilkS: "JLCJLCJLCJLC" (1.0 mm) dentro de la zona de bateria, en (102.5, 33)
    vertical, sin tocar "BATERIA 103450"; README: Order number: Specify a location.
    - Gerbers y zip regenerados. verificar.py y verificar_extra.py sin errores.
2026-10-21 v0.8: pantalla +3 mm, DAC hacia la cruceta, C3 al costado de J5
2026-10-21 v0.8: C2 y C3 con huella de paso 5 mm
2026-10-21 v0.8: justificación de C4 en la spec
2026-10-21 v0.8: continuidad de SW10 confirmada
2026-10-26 v0.9: 155x75, simetría, imagen centrada, DAC adelante, correcciones del profesor
    - Placa 155 x 75 (r = 4), agujeros M2 en (4,4), (151,4), (4,71), (151,71); eje de simetría x = 77.5.
    - Imagen de la pantalla centrada (módulo en x = 73.5, J3 en x = 36.91); RP2350-Plus centrado (68.61 / 86.39);
    zona de batería x 90.5-126.0.
    - DAC adelante con huella propia Connector_KIDBOX:GY-PCM5102_1x06_P2.54mm (KIDBOX/KIDBOX.pretty, gen_huella_dac.py):
    jack centrado en x = 77.5 con la boca en y = 75; C3 y C4 junto a VIN, fuera del DAC.
    - Controles simétricos: cruceta (18, 44), A/B (142, 39)/(132, 49), SELECT/START (41, 67)/(114, 67); SW10 atrás en (50, 8).
    - Correcciones del profesor: 3V3 sin pasar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
2026-10-26 v0.9: 150x70, controles Ø9, muro DAC-pantalla, batería en carcasa
    Ajuste tras la prueba 1:1 (mismo PR #27):
    - Placa 150 x 70 (r = 4), agujeros M2 en (4,4), (146,4), (4,66), (146,66); eje de simetría x = 75.
    - Imagen centrada en x = 75: módulo x 32.41-109.59, J3 en x = 34.41. RP2350-Plus en 66.11 / 83.89.
    - Controles compactos con capuchones Ø9: cruceta (16.5, 39) con brazos de 9 mm, A (138, 34.5), B (129, 43.5),
    SELECT/START (38.5, 62) / (111.5, 62). UP entra por el borde izquierdo (entre columnas quedan 0.5 mm).
    - DAC 5 mm más arriba: J5 en x = 50.1 (VIN y = 66.2), jack con eje en x = 75 y boca en y = 70; C3/C4 junto a VIN.
    - Franja de 4.74 mm para un muro colgante de la carcasa ent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
2026-10-27 v1.0: pistas a 45°, prueba 1:1, versión de fabricación
    Revisión 2 del profesor:
    - gen_pcb.py reemplaza cada codo a 90° por un chaflán a 45° (d = 1.0 mm, o largo/2; menor si hace falta para
    0.29 mm a pads y 0.30 mm a pistas). Esquinas a 90°: 33 -> 0 (112 a 45°, 3 colineales). Sin mover huellas.
    - verificar_extra.py cuenta las esquinas de pista y falla si queda alguna a 90°.
    - Prueba 1:1 de la 150 x 70 (27-oct): fotos en KIDBOX/verificacion/, pendiente cerrado; BOM_compra con un
    100 nF más de repuesto (C2 perdido); README: batería con el cable hacia el conector BAT.
    - Versión de fabricación v1.0: serigrafía, cajetín, ESPECIFICACION, README (sin PRELIMINAR), zip
    KIDBOX_ger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
2026-10-29 Diseño 3d PCB + Componentes
    PCB KIDBOX
    RP2350-Plus
    TFT MSP2402
    DAC GY-PCM5102
    LiPo 103450
    SW1–SW8 pulsadores
    SW10 deslizante
    C2, C3, C4
