jorgeab21/Dise-o_De_Prototipos/(notices)

Notices in the files:
hardware/KIDBOX/KIDBOX.kicad_sch:
Basado en Game*Mite v1.3.2 de Thomas Hugo Williams (CC BY 4.0)
